mk0000001/Open-Pull-Profile/docs/superpowers/specs/2026-10-25-utm-mt02-engineering-iso.md

# UTM V2 / MT02 / engineering-filament feasibility

User scope: compare both projects in detail, source from Ali/China official direct and domestic Korea, assess an all-in KRW500,000 hardware budget, and design missing ISO-related features. User subsequently added PPS-CF, PA6-CF and engineering filaments broadly; confirmed room-temperature tensile testing first. Existing printer/PC/FreeCAD are owned equipment, not new purchases. No purchasing or supplier messages are authorised.

Latest superseding budget instruction: exclude printing costs, aim at KRW600,000 and remain strictly below KRW800,000. Printing filament, printer electricity and printing labour are excluded; purchased hardware, metal fabrication, freight and tax reserves remain included. PETG specimen comparison and engineering-material comparison are parallel routes. The earlier KRW500,000 analyses are retained as dated evidence, not the current budget. A small custom specimen does not satisfy the original full-size/ISO or minimum2kN requirement by itself. No hardware allocation converts an untested layout into a guaranteed load rating.

Preserve original source directories and frozen v0.1–v0.3 artifacts. Work in the existing isolated checkout on `codex/utm-mt02-iso-v0.4`. The original UTM V2 STEP is imported and saved as a separate local reference; its detailed mechanical shapes are not relabelled as a new original design. No authentic MT02 CAD repository has been located. A source-derived MT02 arrangement must say reconstruction, identify changed assumptions and not pretend to be a manufacturing replica.

Approaches examined: original UTM V2 (~1kN demonstrated) is the cheapest single-profile reference; original MT02 has metal mounts and dual ball screws but its 3.5kN is a target, with published comparison tests around800N. Neither existing result establishes the expanded engineering-material scope. Add a separate nominal10kN engineering layout and ISO-related coupon/grip/optical fixture study. This is an extension study authorised by the user's request to design missing features, not an unapproved purchase or certified machine.

Planning envelope: 10kN working target at23°C, nominal40mm² gauge section up to250MPa. Structural screening at15kN is a design input only, not a performed proof test. This bounded envelope does not assert every filament, continuous-fibre composite or conditioned state is covered. A1/A2 specimen names and ISO527-2:2025/ISO20753:2023 apply to the standards audit. Exact current radius/tolerance tables are not fully publicly verified; any generated dogbone is explicitly a nominal geometry study, not an ISO master.

Force, speed, alignment, slip, specimen dimensions, gauge strain, conditioning and AM build/orientation records must each be assessed. Crosshead steps are not a verified extensometer. Class1 force/extensometer performance requires calibration evidence over the used range; HX711 bit count and load-cell capacity are insufficient. Budget separates confirmed public unit prices, taxes/freight assumptions, fabrication allowances, contingency and unpriced calibration. Ali checkout/authenticated sellers remain unverified after a browser safety block; no bypass is attempted.
