mk0000001/Open-Pull-Profile/docs/superpowers/specs/2026-10-24-costdown-v03.md

# v0.3 cost reduction revision

The user changed sourcing to permit AliExpress, requested cheaper profiles and more printed parts, and asked for a quote before committing to a 2 kN machine. Keep the original AEP/HX711 option visible; compare an identifiable alternative rather than silently substituting a cheap scale sensor. Save the FreeCAD file during work. Preserve all upstream and v0.1/v0.2 artifacts.

Use original two geared NEMA17 / TR10x2 drives, original grip geometry and original functional planes. Replace the timber frame with two 4080 columns and three inexpensive metal crossmembers. Print feet, wraps, covers, beam pads and non-load-critical carriers. Metal crossmembers cost only KRW28,710 total at the verified length options; wholesale substitution of these with unqualified plastic is not a sensible 2 kN cost reduction.

The deliverable is a priced layout study, not a fabrication or load-rated release. Explicitly expose unresolved bearing reactions, shaft ends, sensor/grip threads, wiring and physical proof tests. Keep quoted prices, reference prices and allowances separate. The former industrial 2.16 million KRW subtotal was not CNC Kitchen's BOM price. Ali marketplace naming alone does not authenticate a manufacturer or establish a load rating.
