mk0000001/Open-Pull-Profile/UPSTREAM.md

# Provenance

- Original author: Stefan Hermann / CNC Kitchen.
- Original repository: https://github.com/CNCKitchen/Open-Pull
- Actual fork: https://github.com/mk0000001/Open-Pull-Profile
- Baseline commit: 55017419fae89409b1098540212e1620b1e46d0b (2020-06-04).
- License: original GPL-3.0 LICENSE retained. Added design sources use the same license.
- Original CAD/, Arduino/, Electronics/, Documents/ and LICENSE are preserved.
- Reused geometry: upper and lower ClampingYaw assemblies copied from original CAD/TestMachine/OpenPull-assembly.step, transformed into the profile frame coordinate system. They remain unvalidated original grip geometry, not new rated metal grips.
- Added work: profile-frame layout, adapters/envelopes, generator, checks, sourcing notes, Korean documentation.
- No other third-party tester code or CAD is incorporated. Alternative mechanisms are engineering proposals, not claims of endorsement by CNC Kitchen.
