mk0000001/Open-Pull-Profile/profile/DEVELOPMENT_LOG.md

# Development record — 2026-10-24

- User: printed tensile coupons for material/print-condition comparison; profile redesign based on CNC Kitchen; Ali/domestic sourcing with Coupang preference; publish an actual GitHub fork; maintain versions carefully.
- Baseline: original master 55017419fae89409b1098540212e1620b1e46d0b.
- Task1: design scope and provenance documented. Independent builder check found no planning blockers for the authorized concept stage.
- Task2 RED: native CAD validation failed with `Native FCStd has not been generated` before model generation.
- Task2 RED: first generated model failed the100mm pull collision check: crosshead bottom/rear intersected lower beams.
- Ruling: lengthen columns and screws from800 to900 and raise test/upper drive by100 — preserve100mm pull clearance — costs100mm additional overall height and slightly higher material cost.
- Task2 GREEN:58 part shapes valid; no moving-vs-frame/lower-bearing solid intersections at0/-100mm. Belt pitch length920mm at motor Y=-137.048851; proposed calibration640step/mm.
- Ruling: native CAD/source/envelopes are a design-review version, not machining drawings — vendor dimensions and hardware ratings unavailable — production fabrication still needs v0.2 interface work.
- Ruling: use AL6061-T6 as plate sourcing candidate and steel for grip adapters — manageable one-off weight and local availability — stiffness/strength and exact grade remain to be checked.
- Task3: sourcing differentiates product pages, search links, stale/indexed prices and unconfirmed options. No products ordered or supplier messages sent.
- Publishing: initial browser login was required. After user login, actual fork mk0000001/Open-Pull-Profile was created in the browser and profile branch created through the GitHub connector.
- Mechanical validation deferred: structural analysis, full hardware/mating tolerances, grip qualification, fall protection, electrical circuit, calibration and physical repeatability.
- Final review Important finding: omitted lower joint plate caused38400/57600mm3 intersections at-100mm. Expanded fixed-object and moving-block checks reproduced RED. Fix: lower joint plate height80 instead of160; upper plate remains160. Ruling: shorter lower joint plate clears pull path — lower attachment stiffness/rating still needs v0.2 verification.
- Render fix: assign camera-node rotations directly so front/right PNGs are orthographic views rather than frames during FreeCAD view animation.
- Final fix verification: expanded test covers12 moving components against15 fixed frame/support/rail objects at0/-100mm, with58 valid part shapes and no tested collisions. Important reviewer finding resolved RED→GREEN. No deferred minor findings.
- Publishing decision: preserve local development history and publish versioned trees through GitHub Git-data tools, then fetch the authoritative published history locally. Do not force-push or replace upstream history. Create a release tag and Git bundle backup after synchronization.
- User requested a full purchase/assembly audit after login. Manufacturer comparison found the actual3Nm example has10mm shaft/113mm body versus CAD8mm/112mm; actual HGH15CA mounting height28mm versus32mm envelope. ASSEMBLY_AUDIT.ko.md therefore records procurement/assembly HOLD; physical capacity remains unvalidated.
- Direct domestic option checks:4080 801-900mm selected28710KRW;401-500mm band adds15870 to base80 so15950KRW calculated. CAS SBA-500L selected198000KRW. No cart/checkout/supplier messages executed.
- Ruling: do not silently turn verified manufacturer examples into selected Ali/domestic purchases — exact vendor links and mating drawings are still missing — the present release remains a concept with a concrete no-build verdict.
- Published four milestones at GitHub; master/profile branch head3b42c55279079bae95baae74779d05abfe0cae67. Git trees were compared byte-for-byte against local design commits. Original local history retained as codex/local-history-20261024.
- GitHub Actions run40086259943 succeeded on the published head. Native CAD was independently closed/reopened and STEP imported into another document:58 native parts,76 STEP leaf shapes valid, relative volume difference1.6321e-14; bounds510x415x1067mm.
- Final report keeps assembly_ready=false. CI success is not treated as hardware assembly or strength approval.
