mk0000001/Open-Pull-Profile/profile/study-v0.4/QUOTE.ko.md

# 출력비 제외 견적 — 권장60만원 / 최대80만원 미만

2026-10-25 계획가. **권장589,084원 / 강화789,084원**. 배송·세금 충당금 및 예비비 포함, 출력 필라멘트·프린터 전기·출력 노동 제외. 공개 판매가와 미발주 가공/부품 충당금을 합친 예산안이며 결제 가능한 확정 견적은 아니다. [재계산 가능한 전체 항목](CURRENT_QUOTE.json), [독립 예산 검토](research/budget600-review.md).

| 구성 | 권장안 | 강화안 |
|---|---:|---:|
| 공개가 부품 소계 | 240,084원 | 240,084원 |
| 출력비 제외 기본 충당금 | 229,000원 | 229,000원 |
| 전원차단·limit·배선 추가 | 20,000원 | 20,000원 |
| 축 고정·지지·가공 추가 | 30,000원 | 80,000원 |
| 금속 국부 보강 / 그립·센서·반력부 추가 | 20,000원 | 120,000원 |
| 최종 운임·누락·초과 예비비 | 50,000원 | 100,000원 |
| **합계** | **589,084원** | **789,084원** |
| 각각60/80만원까지 여유 | 10,916원 | 10,916원 |

기본 충당금229,000원에는 2060×550 프로파일20,000 / 6001+칼라2개13,000 / 8→12 커플링15,000 / 전체 볼트·T너트35,000 / 그립표면5,000 / ATTiny6,000 / PCB20,000 / HX711 5,000 / 전장15,000 / 기본 차단·퓨즈·limit15,000 / 차폐20,000 / 국내배송25,000 / 국제배송25,000 / 세금·결제 불확실분10,000원이 포함된다. 추가 지원비와 중복하지 않도록 이 금액을 기본분으로 고정했다. 금속 가공은 위 배정액에 포함할 계획이며 실제 업체 견적은 받지 않았다. 일반 유상 조립 노동·공인 교정·고정밀 신율계는 미견적 별도다. **엄격한80만원 상한을 확정한 구매목록은 아직 아니다.**

## 공개 판매가

| 부품 | 수량 | 행 합계 | 근거 |
|---|---:|---:|---|
| STEPPERONLINE17HS19-1684S-PG100 | 1 | 45,276원 | [판매 페이지](https://www.stepperonline.co.kr/nema-17-%EC%8A%A4%ED%85%8C%ED%8D%BC-%EB%AA%A8%ED%84%B0-%EB%B0%94%EC%9D%B4%ED%8F%B4%EB%9D%BC-l-48mm-w-%EA%B8%B0%EC%96%B4%EB%B9%84-100-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) |
| Nasspop714 P0000BBM000H,300mm+MGN12H | 1 | 23,500원 | [판매 페이지](https://nasspop.com/product/detail.html?product_no=714&item_code=P0000BBM000H) |
| Nasspop678 MGN12H block only | 1 | 11,000원 | [판매 페이지](https://nasspop.com/product/detail.html?product_no=678) |
| Nasspop838 P0000BGG000I,T12 lead8x1000mm | 1 | 18,000원 | [판매 페이지](https://nasspop.com/product/detail.html?product_no=838&item_code=P0000BGG000I) |
| Nasspop838 P0000BGG000F lead8nut2400 +P0000BGG000V cut1000 | 1 | 3,400원 | [판매 페이지](https://nasspop.com/product/detail.html?product_no=838) |
| NACHI7201,NavimroK11504922,12x32x10mm,30deg | 2 | 28,578원 | [판매 페이지](https://www.navimro.com/p/K11504922/) |
| VCTEC13582,S500kg,P0000UCJ | 1 | 69,740원 | [판매 페이지](https://vctec.co.kr/product/detail.html?product_no=13582) |
| SZH-EK025 NanoCH340+USB | 1 | 6,050원 | [판매 페이지](https://www.devicemart.co.kr/goods/brand?category_code=00050001&code=1224) |
| VLT-OL023 SSD1306,128x64I2C | 1 | 6,490원 | [판매 페이지](https://www.devicemart.co.kr/goods/view?no=15960990) |
| SMG A4988RED,1327610,heatsink included | 1 | 1,980원 | [판매 페이지](https://www.devicemart.co.kr/goods/view?no=1327610) |
| ComsP5301,24V3A,1329320,ACcordincluded | 1 | 26,070원 | [판매 페이지](https://www.devicemart.co.kr/goods/view?no=1329320) |

국내 판매처와 제조사 중국 직구 조합이다. STEPPERONLINE 한국어 사이트는 국내 재고 판매라는 뜻이 아니다. 알리는 사이트 안전 차단 이후 우회하지 않았으며 판매자 정품·선택 옵션·한국 배송 결제가는 미확인이다. 쿠팡의 저가 기본 표시만으로 다른 슬롯/길이 프로파일을 대체 확정하지 않았다. 프로파일20,000원은 정확한 EU2060 단면·550mm 절단가를 확정하기 전의 충당금이다.

## 실제 시험 범위

**권장안:** PG100 연속 출력3Nm + T12 lead8은 스크루 효율0.3–0.5 가정에서707–1,178N 계산 후보이며 원형도 공개 실증 약1kN 수준이다. PETG 시험 시편5×2=10mm²에서40–60MPa는400–600N이다. PETG 전체10×4=40mm²는1,600–2,400N이므로 같은 기계로 전부 시험된다고 말할 수 없다.

**강화안:** 처음 구매할 때 같은 판매 페이지의 T12 lead2/해당 너트를 선택하는 개발안이다. 기존 조사에서 스크루18,000+너트2,400으로 lead8과 가격 차액0; 절단1,000. 이미 lead8를 샀다면 추가21,400원과 배송이 발생하므로 기존 견적에 그대로 끼워 넣을 수 없다.2kN에 필요한 토크는 같은 효율 가정에서1.27–2.12Nm이나 실제 저리드 효율은 미검증이다. 같은 출력rpm에서 속도1/4,steps/mm4배이며 펌웨어 변경과 부하 속도 실측이 필요하다. **2kN는 유지하는 개발 목표이며 보장 하중이 아니다.** 축력은 모터 허용 축하중50N으로 전달하지 않고 정격 축단·지지·반력판으로 닫혀야 한다.

**엔지니어링 병행:** 같은 장비에 별도4mm² 맞춤 비교 시편을 검토했다. 제조사 대표 XY 인장강도 기준 PPS-CF87MPa→348N,PA6-CF102MPa→408N,PPA-CF168MPa→672N이다.250MPa 소재면1,000N로 여유가 없다. 실제 단면·출력방향·함수율·열처리별 예비시험이 필요하며 단면을 줄이면 적층 경로와 파단 양상도 바뀐다. 이 시편은 ISO527 정규/축소 규격으로 검증된 형상이 아니다. 소재별 수치는 [제조사 근거·조건](research/engineering-filament-envelope.md)을 따른다.

## MT02와 전체 크기 엔지니어링 안

MT02 원형 상당 공개가 부분 합계577,160원, 저가모터·화면 대안514,773원은 금속10부품·가공·그립·체결·배선·차폐·배송 등을 빠뜨린 소계다. 출력비를 없애도 구매목록 전체가80만원 미만으로 입증되지는 않는다. [논문/BOM 검토](research/mt02.md).

원형 상당 안에 금속판/가공150,000,프로파일 천공·탭50,000,커플링30,000,체결55,000,PCB/전장40,000,그립/어댑터80,000,정지25,000,차폐25,000,국내배송30,000,국제배송/세금70,000을 임시 배정하면 **1,232,160원**,예비비100,000 포함 **1,332,160원**이다. 저가모터/화면 대안은 같은 충당금 가정에서1,169,773원/예비비 포함1,269,773원이다. 이는 업체 견적이 아니라 누락 금액을 드러내기 위한 계획가다. 소규모 금속가공을 모두 출력물로 바꾸고도2kN가 성립하는 설계는 아직 확인하지 못했다.

전체40mm²의 PPS-CF/PA6-CF/PPA-CF 대표 XY 파단하중은3.48/4.08/6.72kN다. 별도10kN 프레임/금속그립 설계를 저장했고 자동화 계획 범위는 **약164–303만원**이다. 핵심 지지부·가공 미견적이므로 확정가가 아니다. 수동잭 범위약104–206만원도 일정 시험속도/ISO 적합성을 자동 확보하지 않는다. [상위 하중 견적](research/10kn-upgrade-budget.md).600/800k 현 예산과 합치지 않고 향후 확장 비교 자료로 보관한다.

## 발주 전 해결해야 할 항목

1. 대체 모터·500kg 센서 실도면, 축/나사/높이/여기전압과HX711의 호환성. 원본 CAD 외형과 견적 부품이 동일하다는 주장을 하지 않는다.
2. lead2 너트 플랜지/축단·7201 방향·예압·좌면·칼라 유지력·커플링 토크, 금속 반력부의 실제 도면/가공가.
3. 출력부 인발·크리프·그립 미끄럼·편심·반복하중,정지/limit/과부하/ADC 오류 처리.
4. 교정된 기준으로 힘·부하속도·변위 검증. 인장탄성률을 보고하려면 게이지 길이의 교정된 접촉/광학 신율 측정도 필요하다.

일반 PETG는 **시험 시편 재료**다. 원형 기계 구조 출력물에는 제작자가 강성이 높은PLA계와6–8벽을 권하고 일반PETG를 비권장한다. 재료 이름을 공유한다고 구조부까지 PETG로 치환하지 않는다.
