mk0000001/Open-Pull-Profile/profile/study-v0.4/THIRD_PARTY.md

# Attribution and licensing boundaries

The repository's original CNC Kitchen source remains GPL-3.0 and unmodified.

`utm-derived/UTM_V2_budget_fixture_study.FCStd`, its STEP member in
`STEP_exchange.zip`, and `renders/UTM_V2_budget_fixture_study.png` derive from
Xieshi Zhang / CrazyBlackStone's Universal Tensile Testing Machine Version TWO,
assembly v50. The author describes the hardware as CC BY-NC-SA4.0:
https://hackaday.io/project/192166-low-cost-universal-tensile-testing-machine/
and https://github.com/CrazyBlackStone/Universal-Tensile-Testing-Machine .
License text: https://creativecommons.org/licenses/by-nc-sa/4.0/ .
These derived artifacts are distributed on those hardware attribution,
noncommercial and share-alike terms, not relicensed as CNC Kitchen GPL CAD.
The source repository also contains a GPL3 software license; no claim is made
that the licenses are interchangeable. Clarify the hardware grant before any
commercial distribution.

Changes: FreeCAD import/flattening of142 source leaf solids, jaw packaging for
2mm custom coupons, new PETG and engineering comparison coupons, metadata.
Quoted substitute motor/sensor are not the original solids. This is an
unvalidated packaging study. Source STEP Git blob SHA:
`c535fdf556560d4ac7aa4abba1db6c0b55a113a3`; filename:
`CAD Files/Tensile Testing Machine Assembly v50.step` (15584409 bytes).

MT02 is Stella Demmel's2024 TU Wien thesis:
https://repositum.tuwien.at/handle/20.500.12708/200949 .
The thesis is in copyright; its PDF and figures are not redistributed.
`MT02_source_derived_layout` is our reconstruction from published functional
dimensions, not the author's original FreeCAD model and not an exact replica.
Unresolved source drawing conflicts are recorded in the research and inputs.
Independent10kN requirements CAD and generated custom coupons are project
study artifacts under the repository license. None is a normative ISO master.
