mk0000001/Open-Pull-Profile/profile/domestic-v0.2/SENSOR_GRIPS.md

# 국내 로드셀·로드엔드·그립 조사

확인일: 2026-10-24. 2 kN은 설계 연구 목표이며 완성 장비의 검증된 허용하중이 아니다. 국내 사업자의 국내 판매를 기준으로 조사했고 해외 직구·구매대행은 채택하지 않았다. 가격은 발주 전 재확인해야 한다. 구매·판매자 연락·CAD 변경은 하지 않았다.

## 우선 선정

- **기준 로드셀: 국내용 CAS SBA-500L, 500 kgf(4.903 kN).** 카스몰 상품번호 `1000000249`, 용량 옵션 `SBA-500L`의 추가금 0원 확인, 표시가 198,000원. 카스 양주 주소와 국내 택배/방문수령 안내가 있다. [카스몰 실판매](https://cas-mall.com/goods/goods_view.php?goodsNo=1000000249). 디바이스마트도 동일 모델을 180,000원+VAT=198,000원, 평균 준비 3~4일로 표시한다. [디바이스마트 22818](https://www.devicemart.co.kr/goods/view?no=22818).
- **도면이 완전한 로드엔드 기준: THK NOS12T 우나사 무급유형.** 국내 원일에프에이·주노시스템 상품 `1000003150`에서 NOS12T/NOS12TL 선택 판매. 원문 HTML의 현재 기본가격은 14,520원이며, 검색 캐시의 13,200원보다 높다. 우나사 NOS12T를 지정한다. 국내 택배·인천 반품지·평균 1~3일 안내가 있다. [국내 판매](https://www.wjbearingmall.com/goods/goods_view.php?goodsNo=1000003150).
- **저가 후보: 한국미스미 E-GZW12.** M12×1.75 수나사·우나사·핀홀 12 mm·무급유를 국내 페이지에서 확인. 원문 상품 데이터의 기준 단가는 VAT 별도 3,360원, 포함 3,696원이며 주문정지 플래그는 0이다. 검색 결과에는 10/22 종료 프로모션이 함께 남아 있어 현재 결제 가격/재고를 확정하지 않는다. 전체 d12 치수표와 CAD는 한국판 원문으로 추가 대조 후 채택한다. [한국미스미 E-GZW12](https://kr.misumi-ec.com/vona2/detail/110310557009/?HissuCode=E-GZW12).

## CAS SBA-500L의 실제 도면과 모델링 기준

일반적인 S자 상자 치수가 아니라 **카스 공식 국내 PDF 1쪽의 제품도면, 2쪽의 액세서리도면**을 시각 대조했다. 국내 공식 제품 소개도 200 kgf~1 tf에 M12×1.75 액세서리를 명시한다. [공식 SBA 제품](https://www.cas.co.kr/integration/read.jsp?code=20200813f2610ff062&no=115&reqPageNo=1), [공식 2쪽 PDF](https://www.cas.co.kr/upload/goods/1600822642799_398.pdf).

| 국내 200~500 kgf 행 | 확인 치수(mm) | 의미 |
|---|---:|---|
| A | 51 | 정면 폭 |
| B | 76 | 인장축 방향 본체 높이 |
| C | 19 | 본체 두께 |
| D | 27 | 양 측면 덮개 포함 두께 |
| E | 12.6 | 상하 끝 블록 두께, **나사 유효깊이와 다름** |
| 2-F | M12×1.75 | 상하 인장 포트 |
| 케이블 | 3 m | 인출부 포함 외형 길이는 별도 미치수화 |

CAD 좌표는 인장축을 Z, 정면 51 mm 폭을 X, 두께 19/27 mm를 Y로 두면 된다. 두 포트는 상하면에서 Z 방향으로 체결한다. 도면 중심선은 동축으로 그려져 있으나, 포트의 X/Y 오프셋 공차·유효 탭 깊이·S 슬롯 곡률·케이블 글랜드 돌출 길이는 공개 도면에서 수치화되지 않았다. 이 부분을 정확한 제조 형상으로 단정하지 않는다.

CAS 전용 로드엔드 조립체(200 kgf~1 tf)의 치수는 다음과 같다.

| 공식 액세서리 기호 | 값(mm) |
|---|---:|
| A, 전체 길이 | 211.1 |
| B, 양 핀 중심 간 거리 | 177.1 |
| C, 헤드 외경 | 34 |
| D, 구면 내륜 폭 | 16 |
| E, 홀더 폭 | 12 |
| F, 핀홀 | Ø12 |
| G, 내륜 끝 외경 | Ø15.4 |

`177.1 = 76 + 2×50.55`, `211.1 = 177.1+34`는 조립 치수의 산술 해석이다. 액세서리 독립 주문 형번·정격·스터드 세부 치수·삽입 깊이는 미공개다. **이 길이를 THK/미스미 대체 로드엔드에 그대로 적용하면 안 된다.**

## THK 대체 로드엔드 및 금속 연결부

THK 공식 한국어 카탈로그 A23-10~13에서 아래 수치를 확인했다. [THK 공식 도면/정격 PDF](https://tech.thk.com/upload/product_data/upfile/512K_23_RodEnd.pdf).

| 항목 | NOS12T / POS12 |
|---|---|
| 나사 | M12×1.75 수나사, 우나사; 접미 L은 좌나사 |
| 전체 길이 L / 핀 중심→스템 끝 L1 | 69 / 54 mm |
| 헤드 외경 D | 30 mm |
| 나사부 길이 ℓ | 33 mm |
| 핀홀 d | Ø12 H7 |
| 내륜 폭 B1 / 홀더 폭 B | 16(0/-0.1) / 12 mm |
| 내륜 끝 외경 d1 / 볼 직경 | 15.4 / 22.225 mm |
| 정 레이디얼 하중 용량 Cs | NOS12T 11,000 N / POS12 16,700 N |
| 재질 | 홀더 S35C, 내륜 SUJ2 58HRC 이상 |

Cs는 시험기 조립체의 안전사용하중이나 피로수명이 아니다. 인장축은 로드엔드 스템 축이며 핀에는 레이디얼 하중을 전달한다. THK는 보통하중 핀 끼워맞춤 h7을 안내한다. 대체 급유형 POS12도 국내배송 명시 판매가 있다. [에스엘시스템 POS12](https://myslmall.com/product/pos12-%EC%82%BC%EC%9D%B5thk-%EC%9D%BC%EC%A0%9C-%EC%88%98%EB%82%98%EC%82%AC-%EB%B6%80%EC%B0%A9-%ED%83%80%EC%9E%85-%EB%A1%9C%EB%93%9C%EC%9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).

SBA와 THK를 직접 체결할 때 핀 중심 간 거리는 `H = 76 + 2×(54-e) = 184-2e mm`이며 e는 실제 나사 삽입 깊이다. CAS의 H=177.1로 맞추면 e=3.45 mm에 불과하므로 이를 조립 목표로 삼지 않는다. 센서 탭 깊이·물림 길이·잠금너트·자유 회전 여유를 정한 뒤 H를 결정해야 한다.

**금속 클레비스 설계 입력:** 핀 Ø12, 내륜 폭 16 mm와 그 공차를 수용하는 안쪽 간격, 헤드 Ø30 및 각운동 여유, 양 귀에서 핀을 지지하는 구조. 원본 STEP을 검사한 상위 작업자의 확인값은 그립 축방향 구멍 **Ø17 mm, 깊이22 mm**이며 나사는 모델링되어 있지 않다. 이를 M8이나 M16 나사라고 단정할 수 없다. 센서의 M12 포트와 연결하는 금속 인서트/어댑터는 이 실측 형상에 맞춘 별도 가공품으로 정의한다. Ø12 핀만 보고 안쪽 폭 12 mm인 일반 공압 포크를 고르면 내륜 폭 16 mm와 맞지 않는다. 정확히 맞는 국내 기성 클레비스 형번은 이번 조사에서 확정하지 못했다.

한국미스미의 `CLBDG12-35` 플랜지·너트 고정 힌지핀은 구매 가능한 **검토 후보**다. Ø12 g6, 축부 길이 35 mm, M10×1.5 끝나사, 플랜지 Ø18·두께5, S45C 계열이다. 실제 귀 두께·간격·스페이서에 따라 길이를 다시 고르고, THK의 h7 권장과 g6의 간극 차이를 검토한다. 핀/클레비스 조립의 하중 정격은 미검증이다. [한국미스미 형번](https://kr.misumi-ec.com/vona2/detail/110300095930/?HissuCode=CLBDG12-35), [제조사 치수표](https://jp.misumi-ec.com/vona2/detail/110300095930/).

## 그립: 국내 판매와 성능 확인의 차이

| 후보 | 국내 판매 근거 | 채택 판단 |
|---|---|---|
| CNC Kitchen 원본 ClampingYaw | 보존된 `CAD/TestMachine/OpenPull-assembly.step`; 원본 README는 AEP TC4 5 kN 센서 사용을 언급 | 원형 유지/금속 어댑터 연구는 가능. 센서 용량이 출력 그립의 2 kN 검증을 뜻하지 않음 |
| 쿠팡 와이엠툴 집게형 지그 | 100,000원/1개, 업체직송 표기, 상품 6904740090 | 모델·정격·나사·치수도 공개 확인 불가. 2 kN 확정 BOM 제외. [실제 쿠팡 판매](https://www.coupang.com/vp/products/6904740090) |
| IMADA PGC-2530 | 다인계기 상품1000013915, 916,700원 VAT 포함, 국내 택배/안산 수령지·평균2~5일 안내 | 정격2500N, M10, 턱폭30 mm, 입벌림15 mm, 약750 g. **상부용 검토만 가능:** 제조사는 자중 영향 때문에 스탠드 하부 그립으로 사용하지 말라고 명시. 두 개를 상하 한 쌍으로 선정하면 안 됨. [국내 판매](https://www.dain21.net/goods/goods_view.php?goodsNo=1000013915), [공식 사양·도면·주의 p2/4](https://www.forcegauge.net/pdf/pgc_e.pdf) |

PGC-2530의 제조사 구성 예시는 상부 PGC-2530 + 하부 GTW-2500N이다. 하부품의 국내 특정 판매 옵션은 확정하지 못했다. 저예산 경로는 원본 기구를 보존한 금속 턱/몸체·Ø17×22 구멍에 맞는 전환부의 가공 설계와 실물 검증이며, 원본 출력물의 허용하중을 2 kN으로 기재하지 않는다. [IMADA 공식 구성 예](https://www.forcegauge.net/en/product/detail/pgc010).

## HX711 연결과 측정 한계

SBA는 증폭기 없는 4선 브리지, 정격 출력 3.0±0.3 mV/V다. 권장 여자 10 V, 최대15 V, 입력400±25 Ω, 출력350±3.5 Ω이며 표준/선택 C3 사양을 구분해야 한다. 허용 과부하150%는 장비 운전 정격이 아니다. [CAS 공식 PDF](https://www.cas.co.kr/upload/goods/1600822642799_398.pdf).

HX711은 브리지 입력용 ADC로 gain128에서 차동 입력한계가 `±0.5×AVDD/128`이고 전원은2.6~5.5 V, 출력속도는10 또는80 samples/s다. 예를 들어 브리지와 AVDD를 동일4.3 V로 구동하면 SBA 명목 정격 신호는12.9 mV, 2 kN에서는 약5.26 mV로 범위 안이다. **10 V로 여자한 브리지를 5 V HX711에 그대로 직결하면 공통모드/정격 입력 범위에 맞지 않는다.** 저전압 여자 시 CAS의 정확도 보증 조건은 별도 확인하고 최종 구성 그대로 교정해야 한다. [AVIA 제조사 HX711 데이터시트 사본](https://datasheet.lcsc.com/lcsc/Avia-Semicon-Xiamen-HX711_C43656.pdf).

연결 기능은 E+/E−→여자, A+/A−→차동 신호이며 실제 납품 케이블 색상표를 기준으로 배선한다. 공식 국내 PDF에 색상별 결선이 없어 임의 색상을 지정하지 않았다. ADC의24비트는 장비 정확도가 아니다. 표준 SBA 결합오차0.03%RO를 500 kgf에 환산하면 약1.47 N, 선택 C3의0.02%라면 약0.98 N이며 이는 ADC·조립·온도·교정 오차를 더하기 전이다. 10 SPS는100 ms, 80 SPS는12.5 ms 간격이므로 빠른 파단 피크가 누락될 수 있다. 최종 회로에서 영점 잡음, 구간별 기준하중, 증하중/감하중 반복, 드리프트와 포화, 파단 피크 기록을 검증해야 한다.

## 보류 항목

- 더 싼 CAS SBA 표시가140,800원 페이지는 ‘현재 구매할 수 없는 상품’ 표시가 있어 대체 구매처로 채택하지 않았다. [카스맥시스템 SBA](https://www.scaledpt.kr/product/detail.html?product_no=698&cate_no=72&display_group=1).
- 쿠팡의 무브랜드 S형500 kg 센서는 국내 재고·원제조사 도면·추적 가능한 형번을 함께 확인하지 못해 제외했다. 싱글포인트/시어빔500 kg 제품은 S형 인장 로드셀의 바로 대체품이 아니다.
- 설계 확정 전 남은 값: SBA 유효 탭 깊이와 연결 규정, 대체 로드엔드 물림/잠금너트 높이, 미스미 E-GZW12 한국판 전체 치수·정격, 금속 클레비스 가공도/핀 조립간극, 그립 미끄럼·파손 하중, 전체 정렬·과부하 차단 검증.
