mk0000001/Open-Pull-Profile/docs/superpowers/plans/2026-10-25-utm-mt02-engineering-iso.md

# UTM / MT02 engineering study implementation plan

> **For agentic workers:** REQUIRED SUB-SKILL: Use superpowers:executing-plans to implement this plan task-by-task. Steps use checkbox (`- [ ]`) syntax for tracking.

**Goal:** Deliver source-backed two-project reviews, bounded engineering-material force requirements, updated600k/strict800k feasibility excluding printing costs, and saved FreeCAD designs for missing metrology/fixture features.

**Architecture:** Independent research reports feed a versioned study package. Keep the original UTM reference separate; reconstruct MT02 from published functional dimensions with explicit gaps. Model a separate10kN extension concept and nominal coupons/grip/optical fixtures without upgrading geometric validity into ISO compliance.

**Tech Stack:** FreeCAD1.1/Python, original STEP, public standards previews, manufacturer technical data, JSON price/evidence records.

**Spec:** docs/superpowers/specs/2026-10-25-utm-mt02-engineering-iso.md

## Global Constraints

- Room temperature23°C first; PPS-CF/PA6-CF/PPA-CF and other conventional engineering FFF grades are included in a stated force envelope.
- Latest budget: recommended KRW600,000, strict ceiling below KRW800,000, excluding printing costs. Retain the historical KRW500,000 comparison as dated evidence. Do not drop purchased hardware, freight, fabrication or calibration caveats to fit a headline.
- Working target10kN, screening input15kN, neither physically tested.
- Preserve all original and frozen design files; no purchase, external message or Ali policy bypass.

## Review Focus

- Source capacity headline versus actual demonstrated test load and rated component limits.
- Incomplete totals, hidden import/VAT/fabrication/filament costs and unquoted items.
- Flexural versus tensile data, print orientation, moisture and annealing state.
- Nominal coupon geometry versus latest standard geometry and verification requirements.
- Camera/step resolution versus measured force/strain accuracy and low-force dynamic range.

## Tasks

- [x] Inspect clean isolated branch; preserve prior artifacts; import and save original UTM STEP reference.
- [x] Research UTM V2, MT02 and ISO requirements independently; expand material research after user adds engineering filaments.
- [x] Consolidate source URLs, BOM quantities/prices and all mandatory missing costs into reproducible JSON totals.
- [x] Generate source-derived MT02 layout and independent10kN extension/coupon/fixture concepts; save native after frame and after completion.
- [x] Save parallel UTM-derived PETG/custom engineering coupon packaging study with explicit third-party licensing and unverified substitute-component interfaces.
- [x] Verify reopened CAD, selected mounting/clearance/force-envelope invariants and exported STEP pairing. Record all unresolved mates.
- [x] Independently review evidence/claims, fix important findings, commit and publish the study without a certification or build-ready claim. Published draft PR1; first remote push CI40111816113 passed. Native/STEP and price evidence are preserved; physical procurement/assembly/2kN/ISO work remains outside the achieved feasibility-study checks.
