mk0000001/Open-Pull-Profile/docs/superpowers/plans/2026-10-24-costdown-v03.md

# v0.3 execution plan

1. Freeze the abandoned industrial/500 N studies outside the release; retain previous revisions unchanged.
2. Reuse upstream component solids at documented world transforms. Build profile replacements and bed-sized printed wraps/feet/pads, save native CAD after both stages.
3. Export STEP and individual new printed candidates; visually inspect native assembly and reopen native/STEP for geometric validity and volume checks.
4. Build a machine-wide quote with verified prices versus explicit allowances, original and alternate sensors separately, and a clear 500,000 KRW gap.
5. Run manifest/upstream preservation checks; request independent review of artifacts and claims. Commit and publish a costdown-layout revision with no fabrication-ready or 2 kN guarantee claim.
