mk0000001/Open-Pull-Profile/profile/study-v0.4/research/iso.md

# 출력 시편 인장시험의 ISO 요구사항

확인일 2026-10-25. 대상은 필라멘트로 출력한 인장 시편의 재료·출력조건 비교다. 공개 ISO 카탈로그, 표준 판매처의 합법적 미리보기, 시험기 제조사 문서를 조사했다. 유료 표준 구매·우회·문의, CAD·Git 변경은 하지 않았다.

출력 시편으로 강도를 비교할 수 있다. 다만 모양·로드셀 정격·ADC 비트수만으로 ISO 적합성을 주장할 수 없다. 50만 원 예산에서는 먼저 재현성 있는 비교시험을 구현하고 계측 검증의 범위를 명시하는 접근이 현실적이라는 판단이다.

## 현재 판

| 문서 | 공식 카탈로그 확인 | 용도 |
|---|---|---|
| ISO 527-1:2019 | 2025 확인, 현재 판; 개정 진행 표시 | 일반 원칙 [S1] |
| ISO 527-2:2025 | 2025-06-18 발행, 2012판 대체 | 경질·반경질 성형/압출 플라스틱 [S2] |
| ISO 20753:2023 | 발행 상태, 후속 CD 개발 중 | 시편 치수·명칭 [S3] |
| ISO 7500-1:2018 | 2026 확인 | 힘 측정계 교정·검증 [S9] |
| ISO 9513:2012 | 2022 확인, Cor.1:2013 별도 존재 | 신율계 교정 [S11] |
| ISO 291:2008 | 마지막 확인 2021, 2026 검토 상태 | 상태조절·시험 분위기 [S12] |
| ISO 16012:2015 | 2026 확인 | 시편 치수 측정 [S13] |
| ISO 17295:2023 | ISO/ASTM 52921:2013 대체 | AM 위치·좌표·방향 표현 [S14] |
| ISO/ASTM 52924:2023 | 발행 상태 | MEX/PBF 열가소성 AM 부품 특성 등급화 [S15] |
| ISO/ASTM 52927:2024 | ISO 17296-3:2014 대체 | AM 부품 주요 특성과 시험방법 [S16] |

527-2:2025는 1A/1B를 **A1/A2로**, 기존 Annex A의 1BA/1BB를 **ISO 20753 축소 시편으로** 바꿨다. A1은 직접 사출한 다목적 시편, A2는 기계가공 시편이다. 축소 시편에는 Annex A와 ISO 20753을 함께 적용한다. 따라서 새 형상을 연도 없이 “ISO 527-2 1BA”라 표시하지 않는다. [S2,S5,S6]

AM 시편 자체를 배제할 이유는 없다. ISO/ASTM 52924는 MEX/PBF 열가소성 출력 부품을 명시적으로 다룬다. 다만 출력 A1 모양이 사출 A1과 같은 재료상태를 보장하지는 않는다. 이번 시험은 명시한 출력조건의 인장특성 비교로 설명한다. 낮은 infill 구조의 결과를 벌크 재료 고유 물성으로 해석하지 않는다. 527-2는 1 mm 미만 유연 필름, 일반 강성 발포체/셀 구조와 적용범위가 다르며 연질 TPU에는 별도 검토가 필요하다. [S2,S15; 적용 판단 포함]

## 공개 원문으로 확인한 사항

필수·선호·권고를 구분한 제한적 요약이며 전체 표준을 대체하지 않는다.

| 항목 | 내용 | 조항·구분 |
|---|---|---|
| 힘 측정계 | ISO 7500-1 class 1 | 527-1 §5.1.4 필수 [S4] |
| 신율계 | 접촉식 ISO 9513 class 1, 비접촉식 동등 정확도 | §5.1.5.1 필수 [S4] |
| E용 신율 정확도 | L0=50 mm: ±1 µm; 75 mm: ±1.5 µm; 20–50 mm: ±1 µm | §5.1.5.1 필수 [S4] |
| 그립 | 축 일치, 미끄럼·조기파단·압궤 방지 | §5.1.3 필수 [S4] |
| 반복 | 요구 방향마다 최소 5개, 그립 내부 파단/미끄럼 교체 | §7 필수 [S4] |
| 상태조절 | 재료규격 우선; 부재 시 ISO 291, 최소 16 h(합의 예외) | §8 [S4] |
| 분위기 | 선호 23±2°C·50±10%RH; 수분 비민감성 예외; 시험도 같은 분위기 | §8·9.1 [S4] |
| 치수 측정 | 폭 0.1 mm, 두께 0.01 mm 단위 | §9.2 [S4] |
| E 구간 | 변형률 0.05–0.25% | §3.9 정의 [S4] |
| 인장강도 | 첫 국부 최대 응력 | §3.6.2 정의 [S4] |
| 양면 변형률 평균 | 굽힘 오차 억제 | §5.1.5.1 권고 [S4] |

527-2:2025 §5.2는 **A1의 표점거리 75 mm를 선호**하고 QC/별도 지정 시 50 mm를 허용한다. 이를 A2의 75 mm 권장으로 확대하지 않는다. 현재 Zwick 설명은 A2에 50 mm를 제시한다. §5.3의 22 Hz는 v=1 mm/min, L0=75 mm, 초기 그립간격 L=115 mm, 신호 분해능 r=0.0005 mm인 예다. 모든 시험의 고정 샘플링 하한은 아니다. [S5,S6,S7]

class 1은 정격의 ±1%라는 뜻이 아니다. 제조사 자료는 지시값 오차뿐 아니라 반복·영점·분해능·가역성 등을 해당 측정범위에서 다룬다. 24 bit ADC나 원래 로드셀 정격이 조립계 전체의 등급을 입증하지는 않는다. [S9,S10; 해석 포함]

## 속도: 50 mm/min을 보편적 기본값으로 주장하지 않기

현재 Zwick 공식 설명은 **A1/A2 탄성률 1 mm/min**, 이후 5 또는 50 mm/min을 재료거동에 맞춰 사용한다고 설명한다. 527-1 §5.1.2의 선택 속도 공차 유지가 필요하며 1 mm/min 공차는 ±20%다. 50 mm/min을 모든 플라스틱 강도의 필수/기본 속도라고 확인한 근거는 없다. [S4,S7]

합법적 공개 ISO 527-2:2012 미리보기 §8은 탄성률에 1 mm/min을 요구하고 나머지는 527-1의 절차를 참조한다. 이는 **구판 근거**다. 최신 527-2:2025 §9 전체는 무료 미리보기에 없어서 원문으로 대조하지 못했다. [S18]

2019 §9.6의 “재료규격 우선, 없으면 Table 1 또는 당사자 합의” 문구는 공개 검색에서 대학/재게시 전문에 나타났으나 재배포 권한을 확인하지 못해 이번 보고서의 합법적 1차 검증 근거로 채택하지 않았다. 따라서 **1 또는 5 mm/min의 문서화된 연구 비교 프로토콜**은 제안할 수 있어도, 특정 재료 표준 또는 ISO 10350-1의 단일점 비교데이터 조건까지 충족한다고 약속하지 않는다. ISO 10350-1도 2025판으로 개정되어 별도 대조가 필요하다. [S19]

T12 리드 2 mm·감속 99.5:1 가정의 계산: 1/5/50 mm/min에서 나사 0.5/2.5/25 rpm, 모터 약 49.8/248.8/2487.5 rpm이다. 저속 2 kN 달성이 가능하더라도 50 mm/min·2 kN 동시 성능은 별도 문제다. 고속 정격을 암시하지 않고 실제 하중별 속도·스텝손실을 검증한다. 이 계산은 ISO 조항이 아닌 설계 해석이다.

## 시편 치수의 확인 수준

**현재 최종판 치수표·공차를 완전히 검증하지 못했다.** ISO 20753:2023 공개 PDF는 본문 p4까지여서 §6.2 Table 3/4가 없다. 527-2:2025 Table 1과 Annex A 전체도 공개 무료 미리보기에서 확보하지 못했다. 구판 공차를 2023/2025 공차로 승격하지 않는다. [S5,S17]

| 예비 기구 입력 | A1 계열 | A2 계열 | 확인 수준 |
|---|---:|---:|---|
| 좁은부 폭 | 10 mm | 10 mm | 구 제조사 브로슈어 명목 [S8] |
| 두께 | 4 mm 선호 | 4 mm 선호 | 동일 |
| 좁은 평행부 길이 | 80 mm | 60 mm | 동일 |
| 탭 폭 | 20 mm | 20 mm | 동일 |
| 전장 | ≥170 mm | ≥150 mm | 동일 |
| 초기 그립간격 | 115 mm 명목 | 115 mm 명목 | 현재 공차 보류 |
| 표점거리 | 75 mm 선호 / 50 mm 조건부 | 50 mm | 현재 §5.2·제조사 [S5,S7] |
| 반지름·l2·모든 현재 공차 | 보류 | 보류 | 현행 최종 표 대조 필요 |

20×4 mm 탭을 중심 정렬하는 그립 카트리지, 115 mm 부근 초기 간격 조정, 75/50 mm 카메라 표점 치구는 예비 설계에 쓸 수 있다. 표점거리와 그립간격은 다르다. 전장 전체가 기계 스트로크는 아니고, 그립 높이·최종 연신량을 더해 실제 작업공간을 산정한다. **현재 ISO 시편의 제작용 표준원도는 미출도**다.

20753:2023 §6.1 공개 부분은 풀사이즈가 불편하거나 재료가 적을 때 Axy 축소형을 설명한다. x는 제작방법, y는 1:y 축척이다. Zwick 현재 안내는 A22/A25와 CW를 설명하지만 CW의 주용도는 노화·노출 전후 상대 비교다. CW 또는 임의의 5×2 mm 목 단면을 일반 강도 비교용 현행 ISO 승인 형상이라고 부르지 않는다. Annex A의 사용조건·속도와 최종 치수표가 필요하다. [S7,S17]

작은 시편을 같은 형상·같은 제작조건으로 비교하는 연구는 가능하다는 공학적 판단이다. 대형/소형 또는 다른 제작법 결과를 그대로 합치지 않고 “ISO 527 참고, 사용자 정의/축소 시편, 편차 명시”로 기록한다.

## 하중 범위와 기계 차이

F(N)=예상 최대응력(MPa)×단면(mm²). 단순 하중계산이며 구조 안전율·계측 여유·동적 오버슈트는 포함하지 않았다. 기계 선정은 ISO의 첫 국부 최대 정의뿐 아니라 전체 시험 중 최대 힘도 고려한다.

| 단면 가정 | 면적 | 50 MPa | 60 MPa | 80 MPa | 100 MPa |
|---|---:|---:|---:|---:|---:|
| 10×4 mm | 40 mm² | 2.0 kN | 2.4 kN | 3.2 kN | 4.0 kN |
| 10×2 mm | 20 mm² | 1.0 kN | 1.2 kN | 1.6 kN | 2.0 kN |
| 5×2 mm | 10 mm² | 0.5 kN | 0.6 kN | 0.8 kN | 1.0 kN |

뒤 두 단면은 하중 예시이며 현행 ISO 적합 치수를 승인한 것이 아니다.

| 쟁점 | CrazyBlackStone UTM V2 | TU Wien MT02 | 필요한 증거 |
|---|---|---|---|
| 용량 가정 | 약 1 kN 보고값 | 3.5 kN 목표값 | 이 보고서에서는 독립 인증하지 않음 |
| 40 mm²에서 용량/면적 | 25 MPa | 87.5 MPa | 구조·계측 여유 별도 |
| 기존 2 kN 요구 | 가정상 미달 | 목표상 가능 | 전체 하중경로 검증 |
| 80 MPa×40 mm² | 부족 | 3.2 kN으로 목표 대비 0.3 kN 차이뿐 | 실제 정격·여유 검토 |
| 공간·그립 정렬 | 미확인 | 미확인 | 20 mm 탭·115 mm 간격·유효 스트로크 |
| 힘 class 1 범위 | 미확인 | 미확인 | 장착된 계측계 전체 교정·검증 |
| E용 신율 정확도 | 미확인 | 미확인 | 표점 신율계/교정된 광학계 |
| 실제 속도·DAQ | 미확인 | 미확인 | 하중별 속도·동기 기록 |

2 kN은 10×4 mm 단면의 50 MPa에 해당하므로 모든 일반 필라멘트 출력물을 풀사이즈로 파단시킨다는 범위가 아니다. 80 MPa까지 필요하면 3.2 kN에 여유를 더한 설계 요구를 별도 지정한다. 가격·재고·조달은 코디네이터의 견적 조사 범위다.

## 50만 원 비교시험기의 최소 업그레이드·운영 권고

다음은 공학적 권고이며 표준 전문이나 견적을 대신하지 않는다.

1. 프레임·나사·너트·베어링·연결구·로드셀·그립의 전체 하중경로를 검토한다. 모터 정지토크만으로 기계 정격을 정하지 않는다.
2. 센터링 지그와 재현 가능한 그립 죔을 설계하고, 미끄럼·그립파단을 영상과 파단 위치로 확인한다. 편심과 굽힘은 특히 E를 왜곡한다.
3. 실제 사용할 힘 범위 여러 점을 추적 가능한 기준으로 검증한다. 반복·영점복귀·히스테리시스·드리프트·노이즈를 확인한다. 저하중 추 교정만으로 2 kN class 1을 표시하지 않는다.
4. 스텝 명령과 실제 크로스헤드 변위·속도를 독립 측정한다. 프레임/그립/탭 변형을 포함한 크로스헤드 이동은 표점 신율이 아니다.
5. E 또는 표점 연신율을 보고하려면 신율계를 추가한다. 카메라는 길이척도·렌즈왜곡·카메라 움직임·조명·표식 추적 정확도를 검증한다. 픽셀수/서브픽셀 알고리즘만으로 ±1 µm를 보장하지 않는다. 검증하지 못한 E는 미보고한다.
6. 힘·신율·변위의 공통 타임스탬프와 원자료를 저장한다. 센서부터 기록까지 실제 전달률·필터 지연을 검증한다. 위 22 Hz 예 설정에서 10 sample/s는 충분하다고 주장하지 않는다. 80 sample/s도 정확도 증거가 필요하다.
7. CAD치수 대신 출력 후 단면을 실측한다. 필라멘트 건조 이력과 출력 후 상태조절을 구분한다. 측정 단위는 기기 전체 측정불확도와 같은 개념이 아니다.
8. 시험축·적층 Z축·래스터 방향을 좌표그림/각도로 기록한다. XY/XZ 두 글자만으로 시험축이 모호하면 그림을 추가한다. ISO 17295를 표현 기준으로 참조한다. [S14]
9. 재료 lot·수분·프린터·노즐·층높이·온도·속도·벽·상하층·infill·래스터·냉각·슬라이서/버전·G-code·배치 위치·후처리를 고정/기록한다. 100% infill 설정을 무공극으로 가정하지 않는다.
10. 그룹별 개별곡선·유효 수·평균·표준편차·파단 위치·제외 사유·계측범위/교정정보를 보고한다. 외형 단면 응력을 infill 비율로 다시 나누어 재료 고유강도로 바꾸지 않는다.

권장 표시: **“ISO 527-1:2019 및 ISO 527-2:2025를 참고한 출력 시편 비교 인장시험. 제작·형상·계측·상태조절 편차는 기록하며 정식 적합성은 미검증.”**

## 원선과의 짧은 구분

1.75 mm 원선 시험은 원선의 축방향 성질을 보며 층간 접합·공극·래스터를 평가하지 못한다. 원형 균일 단면 가정 A≈2.405 mm²에서는 50/80 MPa가 약 120/192 N이다. 실제 직경·타원도와 고정법 검증이 필요하고 ISO 527-2 A1/A2 시험이라 부르지 않는다.

## 출처·접근 한계

- S1 [ISO 527-1](https://www.iso.org/standard/527-1): 현재 판·확인연도.
- S2 [ISO 527-2](https://www.iso.org/standard/527-2): 발행·대체·명칭·범위.
- S3 [ISO 20753](https://www.iso.org/standard/83642.html): 현재 판·개발 상태.
- S4 [EN ISO 527-1 공개 미리보기](https://standards.iteh.ai/catalog/standards/cen/63eedfdd-676e-48bd-9a33-3d274e612cd7/en-iso-527-1-2019): 사이트 `Standards Content (Sample)`의 규정 텍스트, §3–9.3. 자동 생성 소개와 원문을 구분. 무료 PDF보다 사이트 공개 텍스트가 더 길었음. §9.6·Annex C 전문 미확보.
- S5 [ISO 527-2:2025 공개 미리보기](https://standards.iteh.ai/catalog/standards/iso/9d55cbc8-5096-4e1e-bb26-ce74eea5c4d9/iso-527-2-2025): 목차·변경내역·§1–5.2 일부. 무료 PDF 3쪽, Table 1/Annex A 전체 미접근.
- S6 [EVS 2025 미리보기](https://www.evs.ee/et/StandardDownload/DownloadPreview?language=EnglishLanguage&productId=161842): 검색 색인 본문 p2의 §5.2·5.3·6.1 확인. 직접 열면 로그인형 다운로드 화면이어서 전체 PDF 확보하지 않음. [제품 범위](https://www.evs.ee/en/iso-527-2-2025)와 대조.
- S7 [ZwickRoell 현재 ISO 527 안내](https://www.zwickroell.com/industries/plastics/thermoplastics-and-thermosetting-molding-materials/tensile-test-iso-527-1-2/): A1/A2·축소/CW 용도·속도·계측. 제조사 해설. 일반적인 최대강도 설명보다 ISO 원문의 첫 국부 최대 정의를 우선.
- S8 [ZwickRoell 브로슈어](https://www.zwickroell.com/fileadmin/content/Files/SharePoint/user_upload/Brochures_EN/Industry_Brochures/99_269_Testing_of_Plastics_and_Rubber_E_EN.pdf): §5.1 예비 명목 치수. 구 공차를 현행 공차로 사용하지 않음.
- S9 [ISO 7500-1](https://www.iso.org/standard/72572.html): 현재 판과 검증 범위. 전문 교정절차 미접근.
- S10 [Xforce K 제조사 자료](https://www.zwickroell.com/fileadmin/content/Files/SharePoint/user_upload/PI_EN/03_677_Xforce_K_load_cells_PI_EN.pdf): 다섯 성능기준 설명. DIY 계측계 인증자료가 아님.
- S11 [ISO 9513](https://www.iso.org/standard/41619.html): 현재 판·정오표. 전문 미접근.
- S12 [ISO 291](https://www.iso.org/standard/50572.html): 현재 판·검토 상태.
- S13 [ISO 16012](https://committee.iso.org/standard/63481.html?browse=ics): 현재 판·범위. 팁/압력 등 전문 미접근.
- S14 [ISO 17295](https://www.iso.org/standard/76471.html?browse=tc): AM 좌표·방향·위치.
- S15 [ISO/ASTM 52924](https://www.iso.org/standard/76909.html): MEX/PBF 열가소성 AM 등급화. 등급화의 시편 수·배치·통계 전문은 이번에 검증하지 않음. 527의 최소 5개를 52924 등급화 충족으로 확대하지 않음.
- S16 [ISO/ASTM 52927](https://www.iso.org/standard/81802.html?browse=tc): AM 시험 특성과 절차. 전문 미접근.
- S17 [20753:2023 공개 PDF](https://cdn.standards.iteh.ai/samples/83642/3f31c860b40e4957b873a9fabbf2153d/ISO-20753-2023.pdf): 본문 p1–4, Axy 정의·Table 1 일부. 최종 치수 Table 3/4 미포함.
- S18 [527-2:2012 공개 PDF](https://cdn.standards.iteh.ai/samples/56046/c5c3ec20cc0741289bf6def861e0a40b/ISO-527-2-2012.pdf): 구판 §8의 E 속도. 2025판 대체물로 사용하지 않음.
- S19 [ISO 10350-1:2025](https://www.iso.org/standard/85826.html): 단일점 비교데이터의 별도 현행 규격. 최신 속도표 전체는 미검증.

비공식 재게시 전문의 재배포 권한은 확인하지 못해 근거로 채택하지 않았다. 두 기계의 자체 정격과 국내/AliExpress 견적은 별도 검증 대상이다.
