mk0000001/Open-Pull-Profile/profile/study-v0.4/research/mt02.md

# MT-02 primary-source audit and Korea budget evidence

Checked 2026-10-25 KST. Research only. No vendor contact, purchase, CAD change, or Git change performed. Files here are ignored research intermediates.

## Conclusions the public report can safely state

1. MT-02 is a materially different design from MT-01: twin geared NEMA17 motors, twin SFU1605 screws, 4080 metal frame, aluminum load-bearing mounts, Arduino Mega, touchscreen. The official thesis is Stella Demmel (TU Wien,2024), DOI10.34726/hss.2024.113842.
2. The thesis specifies a3.5kN goal and computes3.388kN available axial force. The comparison experiment is five PETG specimens per machine with MT02 mean peak800.346N. It does not demonstrate a calibrated2kN or3.5kN operating range. Preserve2kN as our design/validation target, not proven inherited rating.
3. AppendixA.1 has an exact parts list and fastener list, but no prices or total. The official MT01 README underEUR500/1.5kN claim must not be applied to MT02.
4. The selected currently listed near-original Korea procurement basket already sums to about577,160KRW before metal fabrication, several mandatory parts, and delivery/tax unknowns. A dual-direct-NEMA23/3.2touch alternative gives about514,773KRW before the same missing lines. Neither is a complete sub500,000KRW quote. A cheaper Ali-heavy design may be possible but has not been established by verifiable selected-option checkout prices.
5. Native MT02 FreeCAD/PCB/firmware repository and an applicable design license were not located. The thesis says FreeCAD was used; this does not establish downloadable native sources. A CAD recreation should be called MT02-inspired reconstruction from published dimensions, never authentic MT02 CAD.

## Primary sources and reproducibility

- Official record: https://repositum.tuwien.at/handle/20.500.12708/200949
- Official PDF (the literal ellipsis is part of the actual repository filename): https://repositum.tuwien.at/bitstream/20.500.12708/200949/1/Demmel%20Stella%20-%202024%20-%20Design%20manufacturing%20and%20testing%20of%20an%20open-source...pdf
- LocalPDF: mt02-thesis.pdf,3,634,180bytes. Download succeeded with PowerShell Invoke-WebRequest using normal OS certificate trust. No certificate bypass.
- PDF77pages, printed body numbered1–66. Printed page number = PDF page minus11 for these sections.
- Geometry/BOM structured data: mt02-bom.json. Raw relevant geometry text: mt02-geometry-extract.json.
- Rendered figure pages: mt02-pdf-page-29.png (assembly/frame, printed18); -31.png (profiles drawing, printed20); -33.png (mounts drawing, printed22).
- Full extracted text: mt02-thesis.txt and mt02-thesis-layout.txt. The PDF embeds some drawing text as vector paths, so the rendered figures were visually inspected; extraction alone omits dimensions.

MT01 source audit, kept separate:

- https://gitlab.tuwien.ac.at/ilsb-public/mt01
- Public API README https://gitlab.tuwien.ac.at/api/v4/projects/3827/repository/files/README.md/raw?ref=main
- Native assembly https://gitlab.tuwien.ac.at/ilsb-public/mt01/-/blob/main/01_Design_Parts/00_Assembly_FreeCad/Assembly.FCStd
- Current README explicitly licenses MT01©2021–2026DieterH.Pahr underCCBY-NC-SA4.0; it states underEUR500 and up to1.5kN.
- Public API searchmt02 returned[]; ILSB Public group listed onlymt01 andparosol. This is evidence of search outcome, not proof no MT02 source exists anywhere.
- Thesis official record says InCopyright. No native MT02 hardware/software license identified; do not copy MT01 license onto a reconstruction by inference.

## What the thesis actually validates

Printedpp27–28/PDF38–39: thrust calculation3.388kN; the practical travel speed is capped450mm/min for noise, not because of a measured load-speed envelope.

Printedpp35,39–40/PDF46,50–51: manual test0.5–6mm/min, force/time/travel output at5Hz; no separate position sensor, displacement comes from commanded step count. One motor can be jogged independently to realign the crosshead. Movement is hold-to-run on the touchscreen. Force limit is used in manual test mode; travel and other modes ignore load-cell readings. The described overload indications include stepper knocking and possible bottom-beam sliding at bracket joints. These are not a demonstrated calibrated mechanical overload limiter.

Printedp42/PDF53: calibration used a0.5kg reference mass, tare before each specimen,30–40Npreload and1mm/min test speed. The reused MT01 grips haveM8threads while MT02 was designed forM12; improvised washers/M10spacers andM12-toM8adapter were used. Grip/adaptor procurement is missing from the Appendix table.

Printedpp48–56/PDF59–67:fivePETGtests per system; strength agrees approximately1percent, but corrected crosshead-derived modulus0.717GPa versus Zwick video1.483GPa is under by48percent. Corrected ultimate strain7.581percent versus3.869percent is roughly96percent higher. Original raw crosshead-based modulus0.342GPa is even lower. This cannot be sold as accurate modulus/strain measurement without specimen-level optical tracking or a validated compliance correction. A two-sample t-testp=.690 withn5 is not a general equivalence certificate. The thesis has small internal discrepancies for Zwick mean strength40.642/40.648/40.842MPa; report approximately40.4versus40.8MPa instead of overclaiming the final decimal.

AppendixA.2 printedpp64–65/PDF75–76:INA219 current sensing was tried to detect missed steps and discarded because it could not detect them. A4988 was rejected for heat/low speed;DM320T was rejected for abnormal speed behavior. Do not add INA219 to the final validated sensor list or imply a closed-loop force/position system.

Engineering implication (our inference): a low-mass calibration extrapolated to800Ncomparison does not verify2kN/3.5kN. Before claiming2kN, bench verification must cover mounting/joint stiffness, gripper slip, twin-drive synchronization, force zero/span/repeatability/hysteresis through the intended range, and independent measured crosshead travel. A camera can retain a low-cost specimen-strain path, but a purchased camera or calibration target must be budgeted unless already owned.

## Exact BOM and geometry

See mt02-bom.json for all quantities and13fastener rows. Main facts:

- 4080groove8I-type light profiles:590mm×2columns,400mm×3(top+2feet),320mm×1fixed lower beam,300mm×1crosshead; total3000mm.
- Twin500mmSFU1605spindles on244mm centers; original17HS19-1684S-PG19motor×2with19.203:1gearboxes;8-to10mmcoupler×2;DM542T×2.
-5kN wording inbody,500kg wording inBOM forS-type loadcell, M12interface.500kgf=4.903kN, and sensor range does not rate the entire machine.
- Frame nominal400wide×400deep×670high inferred from components, excluding motors/caps. Label this inferred envelope.
- Ten machinedAW6060mounts:2each motor70×78×6,fixed-bearing70×78(6mm inferred),nut80×55×10,floating80×69×10,loadcell/grip60×80×10.
- Low-stress printed parts are housings/caps/cable caps/spacers, not the primary force path. PETG1mmspacers under motor/fixed-bearing mounts;TPUendcap dampers.

Published inconsistencies requiring purchaser drawing verification before fabrication:

- BOM flatbar10×70×500 conflicts with80mmwide finished mounts and prose10×80.
- Fig17nut-mount holes are labeledM4; prose says sixM5holes. DrawingPCD38.23mm.
- Feet drawing appears to labelØ12.25counterbore; prose specifiesØ13.5,12.25deep. Resolve against intendedM8head and selected profile.
- Fixed supportBK12named in printedp26. Floating supportBF12 is plausible from standard component geometry but is not explicitly part-numbered in the BOM. Do not replace withFK12/FF12 silently.

## Current sourcing comparison, not a checkout quote

Listed prices checked2026-10-25. VAT added only when the seller explicitly saysVATexcluded. Foreign manufacturer KRW pages do not mean Korean domestic stock. Final destination shipping/importVAT/cardcurrency fees are unverified.

| Item | A near-original listing amount KRW | B costdown amount KRW | Evidence / limitation |
|---|---:|---:|---|
|4080profile3m|91,500|91,500|Ajin3050/100mm tariff calculation; exact cuts/rounding/kerf, I-type groove match and freight not verified. https://e-ajin.com/product/detail.html?product_no=39 |
|SFU1605L500supportsets×2|158,000|158,000|Mizo exact500mm variant79000 each. Seller option literallyBK12EF12, so support geometry unresolved. https://mizo.kr/product/detail.html?product_no=96&item_code=P00000DS00EE |
|Motors×2|88,888.8|56,240.8|A original geared17HS19-1684S-PG19; B direct23HS30-2804S2Nm. Manufacturer KRcatalogues; overseasdispatch.|
|DM542T×2|60,522|60,522|Exact official product JSON-LD30261each. https://www.stepperonline.co.kr/nema-17-23-24-%EC%8A%A4%ED%85%8C%ED%8D%BC-%EB%AA%A8%ED%84%B0%EC%9A%A9-%EB%94%94%EC%A7%80%ED%84%B8-%EC%8A%A4%ED%85%8C%ED%8D%BC-%EB%93%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 |
|S500kgloadcell|68,200|68,200|VCTEC62000exVAT. Verify tension/compression rating, thread/pitch, geometry. https://vctec.co.kr/product/detail.html?product_no=21203 |
|Mega2560compatible|23,000|23,000|Eduino domestic listing. https://eduino.kr/product/detail.html?product_no=41 |
|HX711|1,870|1,870|DeviceMart1700exVAT. https://www.devicemart.co.kr/goods/view?no=1327440 |
|24V8.8APSU|35,640|35,640|MEANWELLLRS-200-24equivalent, not thesis exact unidentifiedPSU. https://www.devicemart.co.kr/goods/view?no=13231951 |
|3.2touchLCD|49,539.6|19,800|A SSD1289module45036exVAT, shield still missing. B ILI9341THL-CD01SPI18000exVAT. Needs firmware/pin/3.3Vlogic changes.|
|Partial total|577,160.4|514,772.8|No full total is known.|

Motor sources:

- Original official KRcatalogue https://www.stepperonline.co.kr/nema-17-%EC%8A%A4%ED%85%8C%ED%8D%BC-%EB%AA%A8%ED%84%B0%EC%99%80-%EA%B2%BD%EC%A0%9C%EC%A0%81%EC%9D%B8-%ED%94%8C%EB%9E%98%EB%84%88%ED%8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 shows44444.40KRW. Original USprimary page shows28.86USD https://www.omc-stepperonline.com/nema-17-stepper-motor-bipolar-l-48mm-w-gear-ratio-19-1-planetary-gearbox-17hs19-1684s-pg19
- Costdown official KRcatalogue https://www.stepperonline.co.kr/arduino-%EC%8A%A4%ED%85%8C%ED%8D%BC-%EB%AA%A8%ED%84%B0 shows23HS30-2804S28120.40KRW,57×57×76.5mm,6.35mmshaft. Holding torque is not running torque or a calibrated machine rating.
- A LCD https://vctec.co.kr/product/detail.html?product_no=4834 ; B direct listing https://www.devicemart.co.kr/goods/view?no=15454164 (THL-CD01).

The tables do NOT include:10metal mounts andmachining, originalLCDshield/ribbon,PCBfabrication orrewireboard,2couplings,4brackets,34slotnuts,fasteners,PETG/TPU,grippers/compressionplatens/adapters,DCconverter,powerjack/switch/fuse/mainscord/earth,USBcable,limits/emergency-off ifadded,calibrationfixture,delivery/taxes/camera/labor/tools. Adding nominal allowances without verified sources would be an estimate, not a sourced sub500k quotation.

B retains twin drives, tension/compression, live force/touch interface, USBlog and independent realignment as an intended redesign. It requires newmotor mounts/couplings and firmware settings and touchscreen library changes; it is not a drop-in MT02 build.2kNremains a validation target. The thesis itself suggests a stronger direct motor to simplify mounting (printedp57/PDF68).

## A defensible route toward the500kconstraint

First prioritize an engineering budget ceiling rather than falsely claiming a purchase-ready BOM. At500kall-in, components must cost materially below500kto leave delivery, machining andfixture reserve. The verified dual-motor basket does not achieve that.

Potential future costdown: oneNEMA23+oneDM542Tdriving both screws with a2:1timing belt; lower-cost matchedscrew/supportkits; simplemetalplates using ownedtools; keepS-cell/HX711/USB/touch; use an existingcamera for strain. This changes thedrive topology and independent motorjog is replaced by mechanicalphasealignment. The belt/couplers/mounts needdesign andnewprocurement quotes, and motorholding torque cannot prove2kN. Do not present this unquoted concept as retaining every original function or as completeunder500k.

For original-equivalentassembly, credible budget is above the577kpartialbasket by the missinglines; no precisecomplete total is justified yet. For a500kstrict cap, currently justified status is procurement feasibility unconfirmed, not impossible and not established.

AliExpress constraint: ko.aliexpress.com was safety-blocked earlier. It was not accessed through anotherbrowser/rawnetwork here. No selected capacity/length/model shipping-to-Korea checkout prices verified. Searchsnippets/pricehistory/authorlinks must not be substituted for a live purchasable quote.

## Quality checks performed

- Reopened officialPDF:77pages, no embeddedattachments.
- Visually inspected3renderedassembly/dimensionpages and crosscheckedprose.
- Reopened/parsedmt02-bom.json and recomputedbothsubtotals.
- Differentiated hidden soldouttemplate from live status onVCTEC/Ajin usingpublicHTML:loadcell andLCD4834 haveis_soldout_icon=F, notconfirmedoutofstock. VCTEC4851 integratedscreen shield actuallyhasis_soldout_icon=T andis notcounted.
- No trackedfilesedited.
