mk0000001/Open-Pull-Profile/profile/study-v0.4/research/budget600-review.md

# 출력비 제외 60만원 권장 / 80만원 미만 강화안 독립 검토

2026-10-25. 최신 예산은 **출력용 필라멘트·프린터 전기·출력 노동 제외, 권장 600,000원 / 최대 800,000원 미만**이다. 기존 `utm-v2-bom.json`의 500,000원은 이전 조사 조건이며 이 문서가 예산 해석을 갱신한다. 기존 JSON·CAD·추적 파일은 수정하지 않았다. 구매·판매자 연락·Ali 재접근은 하지 않았다.

**판정: 60만원이면 약 1 kN급 원본 복제 후보의 조립·정지·축 고정을 보완할 여지가 생긴다. 80만원 미만에서는 lead 2와 금속 반력부를 포함한 2 kN 개발 후보로 진전시킬 수 있다. 어느 쪽도 조립 완료·정격 2 kN 검증을 의미하지 않는다.** 10 kN 전체 크기 엔지니어링 시편용은 이 저가 BOM의 예산 범위에서 성립했다고 볼 수 없으므로 별도 설계·견적 과제로 남긴다.

## 예산 배분표

기존 공개가를 다시 합산하면 240,084원, 충당금은 259,000원이다. 여기에서 출력재 30,000원만 제외해 **공통 기초 계획 469,084원**을 얻었다. 출력 전기·출력 노동은 원래 합계에 없었으므로 다시 차감하지 않았다. 아래 추가액은 **발주 확정가가 아닌 용도가 지정된 충당금**이다. 새 확정가를 주장하지 않으므로 신규 판매가를 임의로 넣지 않았다. 공통 금액에는 국내 운송 25,000원, 국제 운송 25,000원, 수입세금/결제비 불확실분 10,000원, 기본 차폐판 20,000원, 기본 전원차단/퓨즈/limit 15,000원이 이미 들어 있다.

| 항목 | 60만원 권장안 | 80만원 미만 강화안 | 확보하려는 실제 개선과 제한 |
|---|---:|---:|---|
| 기존 공개가 부품 | 240,084원 | 240,084원 | PG100×1, MGN12H 300 mm+블록2, T12/너트/절단, 7201×2, 500 kg S로드셀, Nano/OLED/A4988/24V3A. 구매 옵션·실물 치수 확인 전 |
| 출력재를 제외한 기존 충당금 | 229,000원 | 229,000원 | 위 배송/세금/차폐/전장, 2060, 6001/칼라, 커플링, 볼트류 등. 합배송/최종 VAT·재고 미확정 |
| 외부 전원차단·limit·배선 보강 추가 | 20,000원 | 20,000원 | 기존 15,000원에 더해 총35,000원 한도. 비상정지 접점으로 드라이버 전원을 실제 차단하는 부품·퓨즈·배선 선정. 인증 안전회로 완성 비용이라는 뜻은 아님 |
| 정격 커플링·축 칼라·베어링 지지 추가 | 30,000원 | 80,000원 | 기존 커플링15,000+6001/칼라13,000원 외 추가. 강화안은 축단/베어링 좌면 소가공 및 금속 고정 지지까지 우선 배분. 부품 허용토크·축 유지력과 실제 가공가 확정 필요 |
| 그립/고정 지그/반력부 금속 보강 추가 | 20,000원 | 120,000원 | 권장안은 금속 받침·와셔/국부 보강 수준. 강화안은 그립/로드셀 어댑터·베어링 반력판과 필요시 백본 보강을 우선. 전체 금속 그립 가공 확정 견적 아님 |
| lead 변경 | 0원 | 0원 차액 | 권장 lead8 유지. 강화는 처음 구매할 때 T12 lead2 스크루/너트 선택: 기존 조사에서 같은 18,000/2,400원. lead8를 산 뒤 추가 구매하면 별도21,400원 및 배송 발생 |
| 최종 운임·가공 초과·누락 부품 예비비 | 50,000원 | 100,000원 | 조립 전에 도면과 공급가를 확정하며 사용. 교정 성적서·기준 힘 측정기를 이 금액에 구매할 수 있다고 가정하지 않음 |
| **출력비 제외 계획 합계** | **589,084원** | **789,084원** | 모두 위 충당금과 예비비 포함 |
| **상한까지 여유** | **10,916원** | **10,916원** | 600,000원 / 800,000원 각각 기준. 강화안은 800,000원보다 작음 |

이 금액은 “해당 금액으로 정격부품·가공·교정이 전부 확보됐다”는 견적이 아니다. 정격 커플링/지지·금속 반력부의 실견적이 배정액과 예비비를 초과하면 보강을 생략하지 말고 범위·예산을 다시 정해야 한다. 공인 힘 교정, extensometer, 기준기 신규구매, 일반 조립/가공 노동은 확정 견적이 없다. 사용자가 제외한 것은 출력 노동이며 금속가공·조립 노동까지 무료로 승인한 것으로 간주하지 않았다. 위 금속 보강액은 재료/소가공 충당금이고 일반 유상 조립 인건비는 별도다.

## PETG 기본안과 엔지니어링 축소시편안

PETG **시험 시편**을 기본으로 삼는 것과 기계의 출력 구조부를 PETG로 만드는 것은 별개다. CrazyBlackStone 원문은 높은 강성의 PLA계 출력과 6–8개 벽을 권하고 일반 PETG 구조부를 쓰지 말라고 한다. 따라서 원본 지그/베어링 하우징을 그대로 PETG로 치환한 조립을 권장하지 않는다. PETG 구조부를 원하면 별도 형상 보강·크리프/층간 검증이 필요하다. 이번 원가에서 출력비를 빼더라도 이 재료 한계는 사라지지 않는다. [원문 조립·출력 지침](https://hackaday.io/project/192166/instructions)

실제 파단하중은 `인장강도 MPa × 실측 단면 mm²`다. **10×4 mm=40 mm² 시편은 2 kN에서50 MPa**에 해당한다. PETG라는 재료명만으로 파단하중이1 kN 또는2 kN 이하라고 단정하지 않는다. 시편 방향·인필·건조·실제 두께를 기록하고 예비 시험으로 범위를 확인한다.

엔지니어링 비교용 축소시편은 하중을 줄이는 별도 운용안이다. 현재 확인한 Bambu PPA-CF XY 대표168 MPa라면 5×2 mm=10 mm²에서 **1,680 N**, 4 mm² 맞춤 단면에서 **672 N**이다. 선택한 재료 상한250 MPa로 계산하면 각각 **2,500 N / 1,000 N**이다. 따라서 lead8 약1 kN급 후보에는 4 mm² 사례가 더 현실적이지만250 MPa에서조차 여유가 없고, 대표 강도에만 맞춘 시편 선택을 보증으로 취급하면 안 된다. 축소하면 적층 경로·벽/인필 비율·그립/게이지 형상의 영향이 달라지므로 **ISO527 전체 크기 적합 시험이나 기존 최소2 kN 충족으로 표시할 수 없다.** [공식 PPA-CF TDS V1.0](https://store.bblcdn.eu/s8/default/f592e57fe69c40289897513bdd2b61bc/Bambus_PPA-CF_Technical_Data_Sheet_2ab26420-79f5-4692-888e-090006814050.pdf)

## 아직 남는 조립 및 2 kN 문제

- **PG100+lead8:** 제조사 연속 출력3 N·m와 스크루 효율0.30–0.50라는 가정에서 계산상707–1,178 N다. 약1 kN 수준 후보라는 기존 판단을 유지한다.2 kN에는5.09–8.49 N·m가 필요해 연속3 N·m를 넘는다. 순간5 N·m를 연속 정격으로 쓰지 않는다. [제조사 PG100](https://www.stepperonline.co.kr/nema-17-%EC%8A%A4%ED%85%8C%ED%8D%BC-%EB%AA%A8%ED%84%B0-%EB%B0%94%EC%9D%B4%ED%8F%B4%EB%9D%BC-l-48mm-w-%EA%B8%B0%EC%96%B4%EB%B9%84-100-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)
- **lead2 강화 후보:** 같은 효율 가정에서2 kN 필요 토크는1.27–2.12 N·m로 줄어든다. 그러나 작은 lead에서 실제 효율이 동일하다는 보장은 없으므로 구동 실험이 필요하다. 같은 출력 회전수에서 속도가1/4이고, 스텝/mm 설정은4배다. 원본 lead8 설정을 그대로 두면 속도·변위가 틀린다. 기존 조사 SKU는 [Nasspop838](https://nasspop.com/product/detail.html?product_no=838)의 스크루 `P0000BGG000G`, 너트 `P0000BGG000D`, 절단 `P0000BGG000V`다. 실제 너트 플랜지 구멍/축단·베어링 좌면은 대조 전이다.
- **축력 반력:** 모터축 허용 축하중50 N에 시험 축력을 직접 전달하면 안 된다.7201 방향·예압, 6001의 실제 역할, 칼라/축단 어깨, 커플링 삽입 길이와 미끄럼 토크를 정해야 한다. 베어링 단품 정격만으로 출력 하우징의 인발·지압을 보증할 수 없다.
- **시편·센서 장착:** 실제500 kg 로드셀의 나사/중심높이/체결 길이·bridge excitation, 그립 개구·유효 stroke·시험 간격, 편심·그립 미끄럼을 확인해야 한다. 센서 정격약4.9 kN를 시험기 정격으로 옮기지 않는다. 금속 보강에도 하중이 출력부/T너트로 우회하지 않는 반력 경로가 필요하다.
- **검증:** 교정된 힘 기준으로2 kN까지 단계하중·반복·영점복귀·미끄럼·영구변형을 확인하고, 정지/과부하/limit/ADC 오류 동작을 시험해야 한다. 아직 물리적 하중 시험·ISO 적합성·2 kN 달성은 확인되지 않았다. 이번 예비비를 교정 완료 증거로 취급하지 않는다.

**진행 권고:**60만원안은 PETG 및 제한된 축소 엔지니어링 시편의 비교 시험용 시제품 조립에 초점을 둔다. 최소2 kN가 필수이면80만원안에서lead2·정격 축 고정·금속 반력부를 우선 검토하고, 실견적과 검증 결과가 나오기 전에는2 kN 완성품으로 부르지 않는다.23°C 전체 크기 엔지니어링 시편용10 kN 설계는 계속 별도 보관한다.
