mk0000001/Open-Pull-Profile/profile/study-v0.4/research/engineering-iso-addendum.md

# 엔지니어링 FFF 재료 범위 확대: ISO 보충 검토

확인일 2026-10-25. 사용자 범위는 PPS-CF·PA6-CF를 포함한 엔지니어링 FFF 재료, 시험온도는 실온 23°C다. 앞선 `iso.md`를 보완하며 CAD·Git·구매·문의는 변경/실행하지 않았다.

**권고 결론:** 넓은 엔지니어링 재료군을 40 mm² 단면으로 시험한다면 10 kN 작업 범위를 검토할 이유가 있다. 그러나 “모든 엔지니어링 필라멘트”는 무제한 범위이므로 **예상 최대응력 250 MPa 이하·단면 40 mm² 이하·23°C·지정한 출력/수분 상태**처럼 경계를 명시한다. 10 kN은 이 경계의 산술 결과이며 현재 DIY 기계의 검증된 정격이 아니다. 15 kN 구조 예비 목표도 검증되지 않았다.

## 1. CF라는 이름만으로 ISO 파트를 정하지 않는다

| 재료·구조 | 관련 현행 ISO | 적용 판단 |
|---|---|---|
| 짧게 절단한 CF가 충전된 경질/반경질 성형·압출 컴파운드 | ISO 527-2:2025 | 범위에 short fibres 충전·보강 컴파운드가 포함됨. 보통의 PPS-CF/PA6-CF 필라멘트 비교의 출발점이 될 수 있음 [E1] |
| 비일방향 섬유 보강의 등방/직교이방 복합재 | ISO 527-4:2023 | 매트·직물·로빙·chopped strands뿐 아니라 short/milled fibres도 포함. 사출 시편은 527-2를 참조한다는 주석 있음 [E2] |
| 완전히 또는 주로 한 방향으로 정렬된 섬유·로빙·테이프 등의 보강 | ISO 527-5:2021 | 일방향 복합재. 서로 다른 각도의 UD층을 쌓은 다방향 적층은 보통 527-4 [E3] |

따라서 “CF는 전부 527-4”, “단섬유는 언제나 527-2”, “래스터가 0°이면 자동으로 527-5”라는 분류는 피한다. 실제 섬유의 길이·연속성·정렬·적층 구성, 시편 제작법, 재료/AM 시험규격과 고객의 시험 목적을 함께 정한다. 단섬유 FFF 출력물에도 유동에 따른 섬유배향과 적층 이방성이 있을 수 있으며, 이는 연속 UD 보강과 같은 의미가 아니다. 이 문단은 공개 범위를 바탕으로 한 적용 판단이다.

출력 A1형 dog-bone의 사용을 결정하더라도 직접 사출 A1과 동일한 재료상태라는 주장은 하지 않는다. AM 문맥에는 ISO/ASTM 52924:2023·52927:2024 및 ISO 17295:2023의 방향/위치 표현을 함께 검토한다. 527-4/-5를 선택하면 dog-bone·탭·그립·시험속도 등을 527-2에서 그대로 옮길 수 있다고 가정하지 않는다. 해당 파트의 시편과 파손모드 요구를 다시 확인해야 한다. [E2,E3,E4]

## 2. PA6-CF 수분 상태: 23°C와 건조는 서로 다른 조건

ISO 1110:2019는 2024년에 확인된 현행 PA/공중합 PA 시편의 가속 상태조절 규격이다. 충전재/첨가제를 포함한 grade도 범위에 들어가지만 2 mass%를 넘는 추출성분 grade는 제외한다. 얻는 평형 수분은 23°C/50%RH와 가깝고 기계적 결과가 조금 다를 수 있다고 ISO가 명시한다. PPS-CF 등 모든 재료의 일반 가속 조절법은 아니다. [E5]

ISO 16396-2:2022는 PA 성형·압출 재료의 시편 제작/특성 규격이다. 공개 미리보기에서 다음을 확인했다. 이 규격의 모든 조항을 FFF에 자동으로 전용한다는 뜻은 아니다. [E6]

- §5.1: 시편의 수분 상태를 보고하며 건조 상태·moist 상태 또는 둘 다의 특성을 다룬다.
- §5.2의 **dry-as-moulded(DAM)**는 단순히 “시험 전 오븐 건조”가 아니다. 성형 직후 방습 보관, 23±2°C에서 최소 24 h, 수분 2 g/kg 이하, 꺼낸 뒤 최대 15 min 이내 시험 등의 정의가 있다. 기준을 넘은 시편을 다시 건조하거나 사전 열처리한 시편을 이 DAM 상태로 부를 수 없다.
- §5.3의 **moist**는 23°C/50%RH에서 평형 도달, 또는 ISO 1110 가속 조절이다. 분위기 등급/공차와 수분 함량을 보고한다. 일반 527의 최소 16 h만으로 PA 평형 도달을 보장하지 않는다.
- §4.1의 성형 전 수분 검증에는 ISO 15512가 인용된다. 이 조항의 대상·재료 범위와 별도로 판단해야 한다.

ISO 15512:2019도 2024년에 확인된 현행 규격이다. 분말·과립·완성품의 **물 함량 측정법**이며 ISO 62의 흡수속도/평형 시험과 다르다. 이것 자체가 모든 ISO 527 또는 모든 FFF 시험에 자동으로 추가되는 의무라는 근거는 확인되지 않았다. 선택한 재료규격/시험계약이 요구하거나 물 함량을 검증할 필요가 있을 때 방법을 정한다. 단순 질량 감소식 수분계가 해당 방법·분해능·시료량에 맞는지도 확인한다. [E7]

이번 비교시험에서는 예를 들어 `23°C, 출력 후 건조·밀봉 상태`와 `23°C, 지정 RH 평형 상태`를 별도 그룹으로 정의한다. 필라멘트의 출력 전 건조, 출력 직후 보관, 출력 후 annealing, 흡습 조절, 시험 전 실온 안정화의 이력을 각각 남긴다. **필라멘트를 건조해서 출력했다는 사실은 시험 시편의 수분 상태를 증명하지 않는다.** 제조사의 annealed/dry/wet 수치를 비교할 때도 각 상태와 시험속도·방향을 맞춘다. 이는 실무 권고다.

## 3. 축소 시편으로 하중을 낮추는 경우

최신 ISO 527-2:2025는 A1/A2와 ISO 20753 축소 시편을 참조한다. ISO 20753:2023 공개 §6.1은 풀사이즈가 불편하거나 재료량이 작을 때 Axy 축소형을 설명하며 x는 제작방법, y는 1:y 축척이다. 현재 Zwick 안내는 A22/A25를 제시한다. 공개된 2023 FDIS 표에는 A12/A22를 1:2로 설명하지만, **FDIS는 최종판 치수표 대신 쓰지 않는다.** [E8,E9]

최종 20753:2023의 §6.2 Table 3/4, 527-2:2025의 Table 1/Annex A 전체를 합법적 무료 미리보기에서 확보하지 못했다. 그러므로 이 보충 검토도 반지름·축소 공차·표점거리·속도를 확정하지 않는다. 임의로 목 폭/두께만 줄이거나 인필을 낮춘 형상을 **full ISO**라고 표시하지 않는다.

단면 10 mm²와 40 mm² 결과는 같은 응력단위로 계산할 수 있어도, 형상·제작·섬유 분포·벽 비중·노치/모서리·변형률속도·파손위치에 따른 차이가 있으므로 동등성을 자동 보장하지 않는다. 짧은 섬유와 비드 폭에 비해 작은 시편에서는 대표성도 별도로 검토한다. 작은 형상 연구가 필요하면 같은 형상과 프로토콜 안에서 비교하고 편차를 명시한다. 이는 공학적 적용 판단이다.

CW는 특히 노화/열·환경 노출 전후 특성의 상대 변화에 활용되는 작은 시편이다. 기계 힘 한계를 맞추기 위한 일반 고강도 ISO 표준 시편의 대체로 자동 승인하지 않는다. [E9]

## 4. 실온 고강도 재료의 힘 범위

F[N]=σ[MPa]×A[mm²]. 아래는 예상 **전체 최대 응력**을 쓰는 설계 계산이며, ISO 인장강도의 첫 국부 최대 정의와 구분한다. 강도값은 재료명만으로 확정할 수 없으므로 해당 제품의 인장 TDS·방향·상태를 대조한다. 굽힘강도를 인장강도로 대입하지 않는다.

| 예상 최대응력 | A=10 mm² | A=40 mm² |
|---:|---:|---:|
| 50 MPa | 0.50 kN | 2.0 kN |
| 100 MPa | 1.00 kN | 4.0 kN |
| 150 MPa | 1.50 kN | 6.0 kN |
| 200 MPa | 2.00 kN | 8.0 kN |
| 250 MPa | 2.50 kN | 10.0 kN |

**10 kN 작업 목표**는 250 MPa×40 mm²를 포함하는 유한한 설계 범위다. 15 kN 예비 구조 목표는 10 kN의 1.5배를 고려하는 설계 선택일 뿐, 파괴하중·허용하중·proof load 또는 안전율을 검증한 수치가 아니다. 프레임·그립·나사·너트·베어링·핀·로드셀·연결구 전체와 편심·피로·운동·과부하 차단을 확인하기 전 작동 정격으로 표시하지 않는다. 2 tf 센서는 약 19.6 kN 정격일 수 있지만, 이것이 프레임을 19.6 kN으로 인증하지 않는다.

PPS-CF 역시 제품마다 다르다. 예를 들어 Bambu 공식 페이지의 인장강도 87±5 MPa를 단순 예측에 사용하면 40 mm²에서 명목 3.48 kN이다. 이는 MT02의 보고된 **3.5 kN 목표**와 사실상 여유가 없으므로 “PPS-CF까지 충분하다”는 포괄적 결론을 내릴 수 없다. 제조사 수치가 이번 시편의 실제 보증값이라는 뜻도 아니다. [E10]

PEEK-CF·PPA-CF를 포함한다고 해도 반드시 모두 250 MPa 이하라는 뜻은 아니다. 연속섬유·특수 강화재, 더 큰 단면, 다른 시험환경·높은 강도 grade는 별도 범위다. 사용자의 “모든 엔지니어링 재료” 요구는 **재료/grade 목록과 최대 하중·치수·신율·시험속도의 명시된 범위**로 구체화한다.

## 5. 10 kN급 힘과 저하중 정확도를 함께 확보하기

10 kN 부근 파단시험을 할 센서도 연한 재료의 작은 힘을 정확히 읽는지는 별도다. ISO 7500-1 class 1을 만족하는 **검증된 하한~상한 범위**가 필요하며 정격만으로 하한을 추정하지 않는다. 표시기·증폭기·ADC·필터·체결·노이즈를 포함한 장착계 전체가 대상이다. 제조사의 교정 범위가 넓다는 설명을 임의 DIY 센서에 전용하지 않는다. [E11]

ISO E 구간 ε=0.0005–0.0025에 대해 σ=Eε로 단순 선형 계산하면:

| 탄성률 가정 | A=40 mm²의 힘 구간 | A=10 mm²의 힘 구간 |
|---:|---:|---:|
| 1.5 GPa | 30–150 N | 7.5–37.5 N |
| 20 GPa | 400–2000 N | 100–500 N |

2 tf≈19.6 kN 센서에서 30 N는 정격의 약 0.153%, 7.5 N는 약 0.038%다. class 1의 지시오차 1%만 예로 들면 각각 ±0.3 N, ±0.075 N 수준이다. 이는 전체 class 판정의 충분조건이 아니다. 고하중 계측만 교정하고 이 작은 힘까지 class 1이라 주장하지 않는다. 반대로 대용량 센서라는 이유만으로 무조건 실패한다고 단정하지도 않는다. 검증된 범위가 결정한다.

실무적으로는 **교체식 500 kgf급(약 4.9 kN) + 2 tf급(약 19.6 kN)** 계측계를 검토할 수 있다. 각 센서의 실제 교정 하한과 시험 중 최대 힘을 맞춘다. 아주 작은 최대 힘만 발생하는 별도 시험에는 100 N급 소형 센서도 선택지다. 100 N 센서로 150 N E 구간이나 수백 N 파단시험을 수행할 수 없으며, 범위를 초과할 가능성이 있으면 사용하지 않는다. 센서 교체 때마다 체결·정렬·영점·교정 매핑을 기록한다. 이 제안은 정확도/용량 설계용이며 기존 예산 안에 모두 포함된다는 약속은 아니다.

## 6. 높은 탄성률에도 시편 표점 신율계가 필요

E=1.5 GPa와 20 GPa 모두 변형률 0.05–0.25%의 **같은 신율 구간**을 측정한다. 50 mm 표점에서는 ΔL=25–125 µm, 75 mm에서는 37.5–187.5 µm다. 탄성률이 높다고 스텝/크로스헤드 이동이 표점 신율로 바뀌지 않는다. 프레임·그립·탭의 유연성, 미끄럼, 편심 굽힘이 여전히 섞인다.

접촉 신율계와 동등 정확도의 비접촉 광학계 모두 선택지다. **광학만 유일하게 허용되는 것은 아니다.** 이 기계가 카메라 방식을 선택하면 50/75 mm 표점의 µm 수준 정확도를 길이 기준·렌즈/화면 왜곡·초점·카메라 강성·추적·양면 굽힘 영향까지 검증해야 한다. 픽셀수·24 bit ADC·스텝 분해능은 측정 정확도 증거가 아니다. 정확도를 검증하지 못하면 E 수치를 ISO 물성으로 보고하지 않고 힘·실측 단면 기반 비교강도와 제한을 보고한다. 기존 `iso.md`의 527-1 §5.1.5.1 근거를 따른다.

## 출처와 접근 수준

- E1 [ISO 527-2:2025 공식 카탈로그](https://www.iso.org/standard/527-2), [공개 범위](https://www.evs.ee/en/iso-527-2-2025): short fibres 충전·강화재 포함. AM에 대한 적합 절차 전체를 보증하는 자료는 아님.
- E2 [ISO 527-4:2023 공식 카탈로그](https://www.iso.org/standard/85809.html): 2021판 대체, 섬유/복합재 범위 및 사출 예외 주석.
- E3 [ISO 527-5:2021 공식 카탈로그](https://www.iso.org/standard/80370.html): UD 복합재 범위, 다방향 층상 재료 구분.
- E4 [ISO/ASTM 52924:2023](https://www.iso.org/standard/76909.html), [52927:2024](https://www.iso.org/standard/81802.html?browse=tc), [ISO 17295:2023](https://www.iso.org/standard/76471.html?browse=tc): AM 관련 현재 문서. 전문 적합성 검증은 미수행.
- E5 [ISO 1110:2019 공식 카탈로그](https://www.iso.org/standard/76395.html): 2024 확인, 충전 PA 포함 범위와 가속 상태의 한계.
- E6 [ISO 16396-2:2022 공식 카탈로그](https://www.iso.org/standard/80312.html?browse=ics), [합법적 공개 미리보기](https://cdn.standards.iteh.ai/samples/80312/cf02ae18bc37423f89889023fdc6e520/ISO-16396-2-2022.pdf): §4.1·5.1–5.3 확인. FFF 시편 전체의 자동 적용을 주장하지 않음.
- E7 [ISO 15512:2019 공식 카탈로그](https://www.iso.org/standard/73834.html?browse=tc): 2024 확인, 수분 함량과 흡수 시험 구분. 방법별 전체 적용 조건 미검증.
- E8 [ISO 20753:2023](https://www.iso.org/standard/83642.html), [최종판 공개 미리보기](https://cdn.standards.iteh.ai/samples/83642/3f31c860b40e4957b873a9fabbf2153d/ISO-20753-2023.pdf): §6.1 Axy. [2023 FDIS 공개 표](https://cdn.standards.iteh.ai/samples/83642/2a6a5695da0547d79803b19255cbfdc7/ISO-FDIS-20753.pdf)의 1:2 표기는 참고이며 최종 제작 치수 승인에 사용하지 않음.
- E9 [ZwickRoell 현재 ISO 527 설명](https://www.zwickroell.com/industries/plastics/thermoplastics-and-thermosetting-molding-materials/tensile-test-iso-527-1-2/): A22/A25, CW 용도, 계측과 범위. 제조사 해설.
- E10 [Bambu PPS-CF 공식 페이지](https://us.store.bambulab.com/collections/bambu-lab-3d-printer-filament/products/pps-cf): 인장 87±5 MPa 예시. 굽힘 수치와 분리해 사용. 이번 출력물 보증값이나 보편 PPS-CF 값이 아님.
- E11 [ISO 7500-1:2018](https://www.iso.org/standard/72572.html), [Xforce K 제조사 계측범위 설명](https://www.zwickroell.com/fileadmin/content/Files/SharePoint/user_upload/PI_EN/03_677_Xforce_K_load_cells_PI_EN.pdf): 범위별 class 개념. 특정 DIY 로드셀/기계의 class 인증자료는 아님.

고강도 재료의 TDS와 실제 파단하중, 센서 교정 하한, 현재 최종 시편표·축소 Annex A는 후속 검증 항목으로 남는다. 10/15 kN 구조 및 예산 충족을 이 조사 보고서가 입증하지 않는다.
