mk0000001/Open-Pull-Profile/profile/domestic-v0.2/renders/right.png

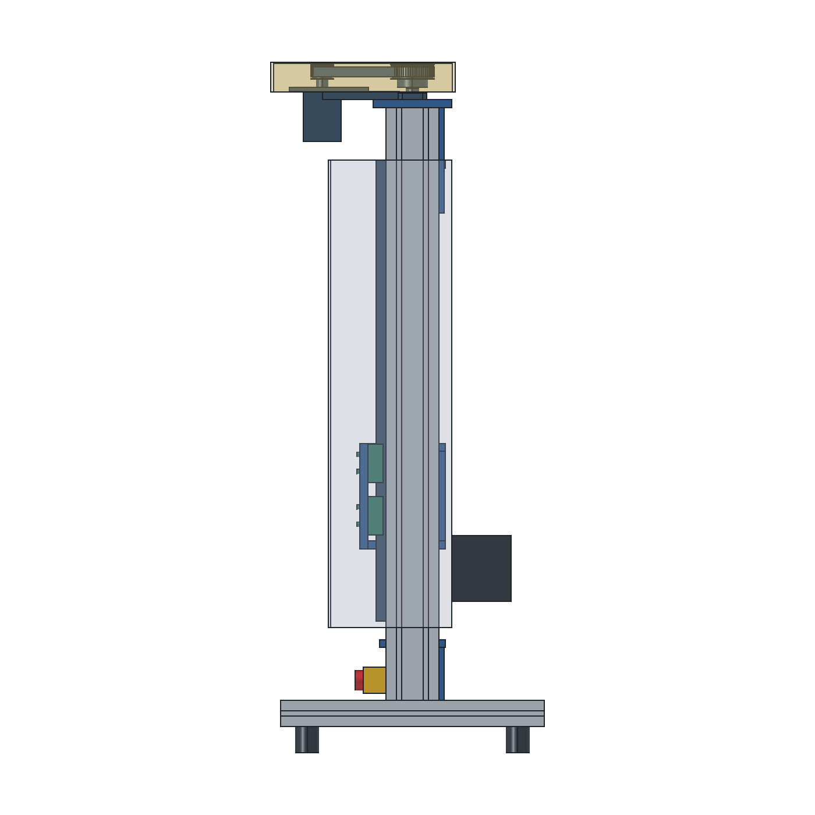
profile/domestic-v0.2/renders/right.png
