mk0000001/Open-Pull-Profile/profile/study-v0.4/renders/Engineering_10kN_room_temperature_study.png

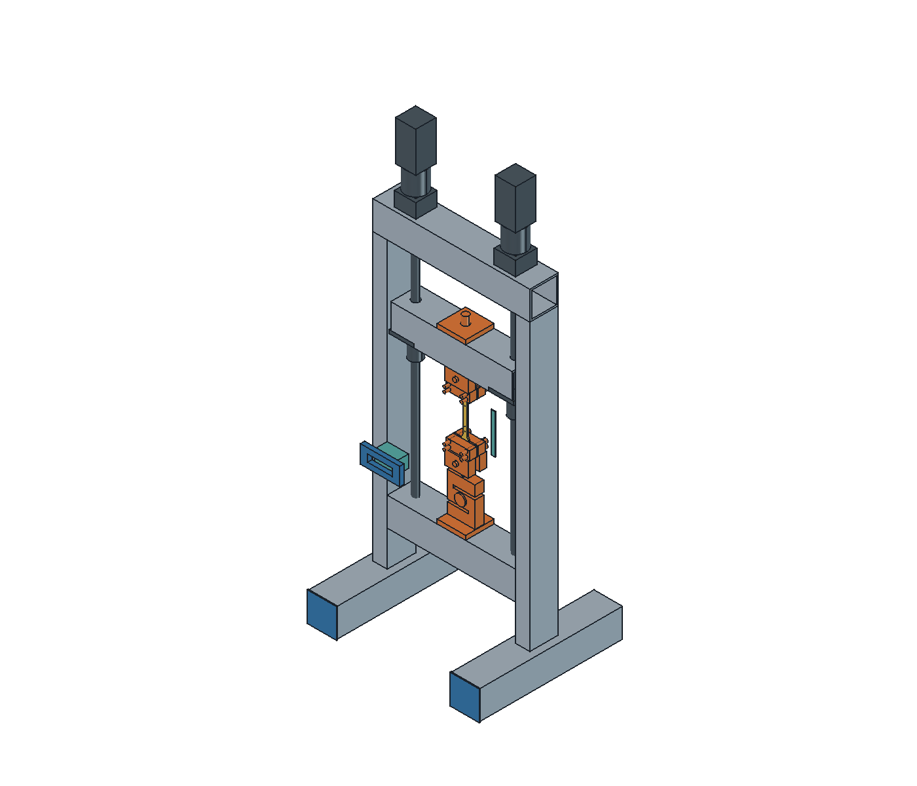
profile/study-v0.4/renders/Engineering_10kN_room_temperature_study.png
