mk0000001/Open-Pull-Profile/profile/study-v0.4/renders/MT02_source_derived_layout.png

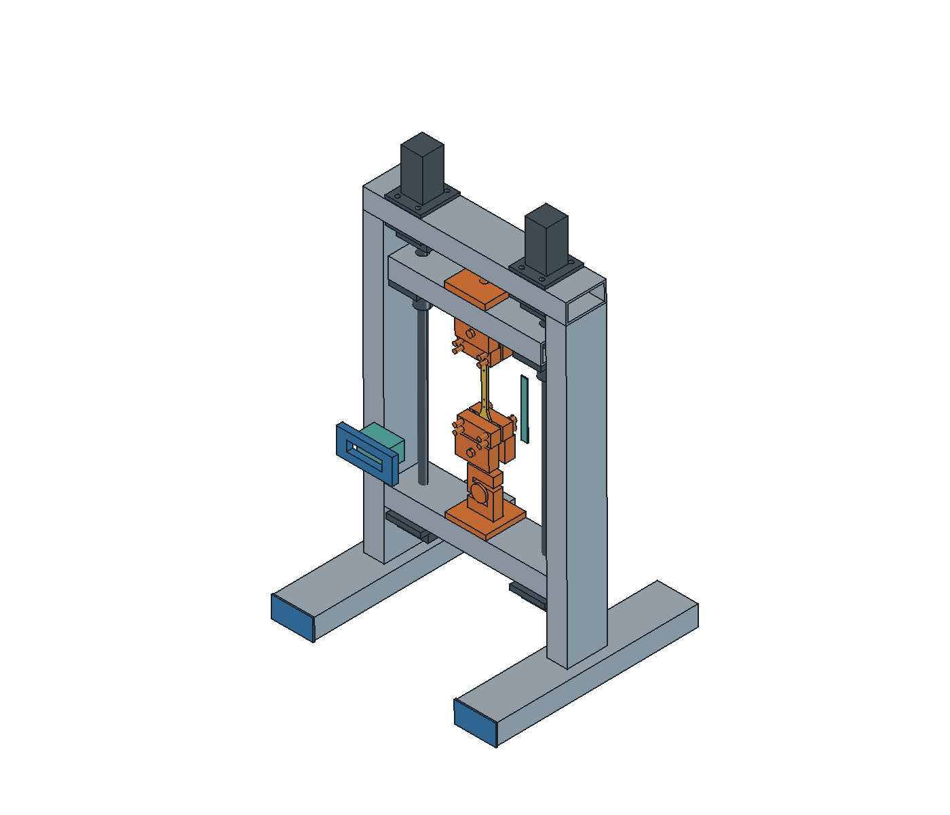
profile/study-v0.4/renders/MT02_source_derived_layout.png
