mk0000001/Open-Pull-Profile/profile/SOURCING.ko.md

# 부품 소싱 — 2026-10-24 검토

**이번 목록은 구매 후보와 옵션 점검표다. 주문·견적 문의는 실행하지 않았다.**

추가 실조회: 국내4080의900mm 옵션28,710원/개, 카스몰 SBA-500L 옵션198,000원을 확인했다. 실제 규격 불일치가 있으므로 전체 발주 판정은 [조립 검증의 보류](ASSEMBLY_AUDIT.ko.md)를 따른다.

구매 경로는 프로파일/절단판을 국내 전문점에서, 전자부품을 쿠팡에서 우선 비교하고, 볼스크류·가이드를 알리에서 같은 판매자의 호환 세트로 조달하는 방향을 추천한다. 쿠팡 입점만으로 국내 재고나 로켓배송을 의미하지 않는다.

페이지를 확인한 날짜와 판매가의 시점은 다를 수 있다. 쿠팡 검색 자료에 과거 도착일이 나타났고 일부 직접 접속은403이었다. 아래 표시 금액을 오늘의 확정 가격으로 쓰지 않았다. 상품이 여러 용량/길이를 한 페이지에 묶은 경우 최저 옵션 가격은 해당 설계 규격 가격이 아니다.

| 부품/필요 옵션 | 우선 후보 | 확인 상태와 판단 |
|---|---|---|
| 4080: 900×2 + 420×4, 총3.48m | [영진 4080 실버](https://www.yjprofile.co.kr/goods/goods_view.php?goodsNo=1000000051) | 실제801~900 옵션 선택28,710원/개.401~500 옵션 표시로420은15,950원/개 계산.4080 소계121,220원. 세부길이/수량 필수 입력. 홈 폭·단면도/I값·끝면 가공은 미확정. |
| 4040: 400×2 | [영진 4040 실버](https://www.yjprofile.co.kr/goods/goods_view.php?goodsNo=1000000046) | 상품 페이지 확인. 동일 업체의 브라켓·홈 너트로 계열을 맞추는 편이 낫다. |
| 프로파일 대안 | [미스미 4060/4080 계열](https://kr.misumi-ec.com/vona2/detail/110310158669/) | 제조사 카탈로그 후보. 실제 길이·형번 옵션과 배송비로 다시 비교해야 한다. |
| 판재: 8/12mm, 목록 별첨 | [제일알루미늄 원·부자재](https://www.jeilal.com/bbs/content.php?co_id=03_01) | 6061 등 판재 절단 판매와 8~65T 취급을 확인. 6061-T6 조질, 소량 절단·홀 가공 여부는 미확정. 최종 도면 전 가공 발주 금지. |
| SFU1605 두 축, 900 후보 + BK12/BF12 각2 + 너트 하우징2 | [알리 규격 검색](https://www.aliexpress.com/w/wholesale-SFU1605-900mm-BK12-BF12.html) | 검색 링크이며 선정 상품이 아니다. 전체길이900/나사부900 혼동, 좌우 끝단 동일 가공, 베어링 축하중, 단방향/양방향 정격을 확인한다. |
| 볼스크류 개별 상품 탐색 후보 | [알리 item 1005007307289846](https://www.aliexpress.com/item/1005007307289846.html) | 외부 검색 색인에 SFU1605 등 복수 규격 상품으로 잡힘. 알리 원문 직접 확인 불가. **900 옵션·세트 내용·재고·가격 미확인, 구매 추천 확정 아님.** |
| HGR15 700×2 + HGH15CA 블록4 | [알리 규격 검색](https://www.aliexpress.com/w/wholesale-HGR15-700mm-4-blocks.html) | 같은 판매자/같은 레일 계열의 세트 도면 필요. 이름만 유사한 MGN15와 혼합하지 않는다. |
| 가이드의 쿠팡 탐색 후보 | [쿠팡 HGR15](https://www.coupang.com/vp/products/8600585164) | 검색 제목은460mm였다. **이번700mm 규격과 달라 바로 주문할 대상이 아니다.** 원문403으로 옵션 미확인. |
| S형 인장 로드셀500kgf | [쿠팡 PUSHTON S형](https://www.coupang.com/vp/products/9246574572) | 검색 자료 표시43,600원, 여러 용량 혼합. **500kg 옵션 가격·탭·교정 성적서 미확인.** 직접 접근403. 쿠팡 해외 구매대행 여부 확인 필요. |
| 로드셀의 국내 대안 | [CAS SBA 제조사](https://www.cas.co.kr/integration/read.jsp?code=20200813f2610ff062&no=115&reqPageNo=1), [국내 판매 후보](https://tstshop.co.kr/product/cas-%EC%B9%B4%EC%8A%A4%EC%A0%84%EC%9E%90%EC%A0%80%EC%9A%B8-%EC%9D%B8%EC%9E%A5%ED%98%95-%EB%A1%9C%EB%93%9C%EC%85%80-sba-series-sba-25l-5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) | 제조사에서 인장/재료시험기 용도를 확인. 판매 페이지 기본 표시140,800원, 용량 옵션 미선택. SBA-500L의 가격·외형·M12 여부·액세서리를 별도 확인한다. |
| 로드셀의 옵션 확인 후보 | [카스몰 SBA-500L](https://cas-mall.com/goods/goods_view.php?goodsNo=1000000249) |500L 옵션 실제 선택1개198,000원. 공식 자료의200kgf~1tf 액세서리 나사 M12×1.75 확인. 외형·로드엔드·그립 전환 어댑터는 별도 설계 필요. |
| 저가 로드셀 알리 탐색 후보 | [알리 item 1005005915852645](https://www.aliexpress.com/item/1005005915852645.html) | 외부 색인상 S형 다중 용량 상품. 원문/500kg 옵션 확인 불가. 정확도·탭·교정 이력 확보 전 채택 미정. |
| HX711 모듈1개 | [쿠팡 스마트포커스](https://www.coupang.com/vp/products/8941551676) | 상품 페이지 표시880원+배송3,000원. 과거 도착일 노출로 최신 재고/금액 미확인. 80SPS 전환 가능 여부, 출력 센서와 전압 호환 확인. |
| NEMA23 약2~3Nm 1개 | [쿠팡 검색](https://www.coupang.com/np/search?q=NEMA23%203Nm), [알리 검색](https://www.aliexpress.com/w/wholesale-NEMA23-3Nm-stepper-motor.html) | 검색 링크만 제공. 57각, 축8mm, 모터길이112 이하 공간 가정. 토크-속도 곡선·상전류·축길이·드라이버 호환과 낙하 방지 방식 확정 전 구매 보류. |
| DM542급 드라이버1개 | [쿠팡 모터베이 DM542](https://www.coupang.com/vp/products/7796163351) | 상품 제목과 판매자 검색 자료 확인, 직접 페이지 불가. 피크/RMS 전류, 입력광커플러 전압, 모터 상전류에 맞게 실제 모델 선정. |
| HTD5M 20T×1/40T×2, 폭15 + 920-5M-15 벨트 | [쿠팡20T 후보](https://www.coupang.com/vp/products/8677758567), [알리 벨트 검색](https://www.aliexpress.com/w/wholesale-920-5M-15-timing-belt.html) | 풀리 후보는 해외 구매대행 표기. 20T는모터8mm축,40T는실제 나사 끝단 보어에 맞춘다. CAD 순수 피치길이920mm, 모터 Y=-137.049mm. 플랜지·치형·제조 공차·텐셔너 여유는 추가 검토한다. |
| MCU/24V PSU/스위치·함체 | [쿠팡 Nano 검색](https://www.coupang.com/np/search?q=Arduino%20Nano%20ATmega328P), [쿠팡24V 검색](https://www.coupang.com/np/search?q=24V%2010A%20SMPS) | 검색 링크. 기존Nano와 다른 Nano Every/33계열을 무심코 대체하지 않는다. AC 배선·접지·퓨즈·전장함 포함 견적. |
| 차폐/비상정지/리미트/낙하 방지 | [쿠팡 PC판 검색](https://www.coupang.com/np/search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), [쿠팡 비상정지 검색](https://www.coupang.com/np/search?q=%EB%B9%84%EC%83%81%EC%A0%95%EC%A7%80%20NC) | 검색 링크. CAD는4mm PC 공간만 제시한다. 낙하 포획/브레이크는 상품 미선정. 기본 BOM에 누락하지 않았다. |

## 예산 틀 — 판매자 견적이 아닌 작성자 추산

| 묶음 | 예상 범위(원) |
|---|---:|
| 절단 프로파일 | 135,000–180,000 |
| 판재·어댑터 절단/가공 | 150,000–300,000 |
| 두 볼스크류·너트·지지대 | 100,000–180,000 |
| 두 레일·네 블록 | 60,000–120,000 |
| 모터·드라이버 | 80,000–150,000 |
| 벨트·풀리·텐셔너 | 25,000–60,000 |
| 국내 CAS SBA-500L 센서 | 198,000 |
| MCU·ADC·PSU·배선 | 60,000–100,000 |
| 차폐·비상정지·리미트·낙하 방지 | 60,000–180,000 |
| 체결부품·브라켓·조절발 | 40,000–80,000 |
| **합계(국내 센서 기준)** | **908,000–1,548,000** |

배송·세금·공구·그립 금속 제작·전문 교정 및 센서 액세서리 비용은 별도다. 기성 부품 가격보다 **한 대 분량 판재 가공비**가 크게 달라질 가능성이 있다. 이 비용으로 구매 확정하지 않고, v0.2 가공도 확정 후 견적을 받는다. 이 범위는 초기에 제시한 저가 센서/프로파일 추산을 실제 옵션 조사로 수정한 값이다.

## 추천 구매 순서

1. 프로파일 단면도/홈 규격, SFU1605 끝단·BK/BF 도면, 레일 도면, S형500kg 센서 도면을 확보한다. 현재 대체안 중 하나를 먼저 고른다.
2. 그 도면으로 FreeCAD 연결부와 가공도, 낙하 방지 방식을 확정한다.
3. 프레임·금속 연결부 견적을 먼저 합산한 뒤, 정밀 부품을 같은 규격 세트로 발주한다.
4. 체결·원점·무부하 이동 확인 후 센서를 교정한다. 작은 시편부터 실제 반복성/파손·미끄럼을 확인한다.

검색 결과의460mm 레일,20kg 싱글포인트 로드셀,150mm 소형 슬라이드 같은 유사 상품을 이 설계의 대체품으로 주문하지 않는다.
