mk0000001/Open-Pull-Profile/profile/domestic-v0.2/SOURCING.ko.md

# 국내 판매 기준 소싱 비교 — 2026-10-24

결론: **프레임은 국내 절단 전문점과 쿠팡을 비교하고, 볼스크루·지지대·가이드는 정확한 도면이 있는 한국미스미 경제형을 기준으로 삼는 조합**이 현재 가장 검토하기 쉽다. 미스미가 무조건 더 비싸다고 가정하지 않는다. 가격 미공개 품목은 견적 미확정이며 0원으로 합산하지 않았다. 주문·장바구니 추가·판매자 연락은 하지 않았다.

## 프로파일: 쿠팡에서도 살 수 있다

| 국내 판매 경로 | 확인된 가격/옵션 | 이번 설계에 적용하는 조건 |
|---|---|---|
| [쿠팡 동원테크4080](https://www.coupang.com/vp/products/8528493043) | **100mm 4,080원**, 배송4,000원, 로젠택배: 검색에 저장된 상품 정보 | 국내 택배 판매 후보. 쿠팡 직접 열기는403, 최신 결제 화면·900/420mm 절단 옵션·단면 도면 미확인. 100mm 가격을9배해서 확정 견적이라고 쓰지 않음 |
| [쿠팡 와이에스테크 규격/절단 선택](https://www.coupang.com/vp/products/6215203988) | 검색 정보4080블랙100mm5,000원, 배송4,000원 | 기본 옵션·색상별 가격이 다름. 국내 판매자/CJ 배송 후보이나 최종 필요 옵션·홈 규격·재고 재확인 |
| [YJ 경희4080실버](https://www.yjprofile.co.kr/goods/goods_view.php?goodsNo=1000000051) | **900mm28,710원**, **420mm15,950원**. 기본80원+구간 추가금28,630/15,870 | 실옵션과 필수 절단길이 입력 확인. 900×2+420×4=**121,220원**, 배송·구멍가공 별도 |
| [YJ 경희4040실버](https://www.yjprofile.co.kr/goods/goods_view.php?goodsNo=1000000046) | 301~400mm 옵션 추가7,840원+기본80=**400mm7,920원** | 400×2=15,840원. 프로파일8개 총 **137,060원**, 배송·추가가공 별도. 4040가격은 현재 옵션HTML을 읽어 계산, 결제 견적 아님 |
| [한국미스미 HFS8-4080](https://kr.misumi-ec.com/vona2/detail/110302690310/), [공식 도면](https://kr.misumi-ec.com/pdf/fa/2015/p2_0659.pdf) | HFS8-4080-900×2, -420×4 기준 견적. 4040-400×2도 별도 견적 | 국내 정식 판매 경로. 지정길이 가격은 공개 화면에서 확정 못함. 일본 엔화표/과거 카탈로그 가격을 원화 견적으로 쓰지 않음 |

**동일 단면 비교가 먼저다.** HFS8-4080은 ‘8시리즈’지만 실제 홈 폭은10mm, 홈 간격40mm, 코어홀10.5mm다. 쿠팡·국내4080이 이를 그대로 따른다고 가정하지 않는다. 프로파일/호환 너트/브래킷을 같은 단면 계열로 묶고, 재질·중량·단면2차모멘트·절단 직각도·길이 공차·필요한 축 통과 구멍 가공까지 확인한 뒤 결정한다. 경량/중량 프로파일도 같은 품목으로 가격 비교하지 않는다. 일반 프로파일 면에 가이드를 바로 달아 정밀 평행도가 확보된다고 보지 않는다.

필요 절단표는4080 900mm2개,420mm4개 /4040 400mm2개다. 쿠팡에는 이8개와 호환 부속, 배송·가공을 합한 실제 옵션 합계가 확보되면 비교할 수 있다. 현재는 쿠팡이 최저가라고 확정할 근거가 없다.

## 구동·계측 국내품 선정표

| 품목/수량 | 도면 기준 국내 판매품 | 현재 가격 근거 | 쿠팡/저가 대안 판단 |
|---|---|---|---|
| 모터1 | [Leadshine57CM23-3A, 옵션P0000CGZ000D](https://motiongearon.com/product/detail.html?product_no=1533) | **42,900원**+배송3,500, VAT 별도 표기 없음. 실판매 옵션 확인, 실재고 수량 보증 아님 | [쿠팡 Scipia CIC57100](https://www.coupang.com/vp/products/8550726815?itemId=603332816&vendorItemId=4581242864)44,700원 검색가. 제조사OEM, 축길이20/23 표기 충돌 → CAD 기준 제외 |
| 드라이버1 | [정품 LeadshineEM542S 국내 WITHFA](https://www.withfa.co.kr/stepper-motor/leadshine), [Motor114](https://leadshine.co.kr/product/view.php?pcode=PROD00000000051) | **국내 견적 필요**. 제조사 전류/전압/입력 매뉴얼 확보, 현지 실재고 미확정 | [쿠팡 OEM A7Q DM542](https://www.coupang.com/vp/products/1432305817?itemId=2473811862&vendorItemId=70467187979)29,800원 검색가. 정품 Leadshine 사양을 대신 적용할 수 없어 보류 |
| 볼스크루2 | [C-TBSE1505-861](https://kr.misumi-ec.com/vona2/detail/110310435959/?HissuCode=C-TBSE1505-861) | 정확한861 품번 주문인식 확인, **금액 견적 필요** | 국내 Mizo 저가품은 현재 품절. 쿠팡 SFU1605는 국내재고·제조사·같은 끝가공 확인 못해 미채택 |
| 고정지지2 | [C-TFK12](https://kr.misumi-ec.com/vona2/detail/110310392219/?HissuCode=C-TFK12) | 개당20,364원 VAT별도 | C-TBSE에 맞는 조합. 다른 HIWIN/무브랜드 FK 정격을 빌려 쓰지 않음 |
| 부동지지2 | [C-TFF12](https://kr.misumi-ec.com/vona2/detail/110310392309/?HissuCode=C-TFF12) | 개당5,726원 VAT별도 | 지지대4개 합52,180원+VAT=**57,398원** |
| 레일2/블록4 | [E-HLGH15-700-B2×2](https://kr.misumi-ec.com/vona2/detail/110311122029/?HissuCode=E-HLGH15-700-B2) | 정확한700/B2 품번 주문인식 확인, **세트 견적 필요** | 국내 HIWIN 판매 대안은820레일2+블록4=267,000원(배송/VAT별도 확인). 쿠팡 동명이품의 국내재고·정품 확인 불가 |
| 풀리1+2 | [HTPA20S5M150-A-P8](https://kr.misumi-ec.com/vona2/detail/110300406030/?HissuCode=HTPA20S5M150-A-P8), [40T/P10](https://kr.misumi-ec.com/vona2/detail/110300406030/?HissuCode=HTPA40S5M150-A-P10) | **형번별 견적 필요** | 모두 S5M으로 통일. HTD5M 혼용 금지. 축 고정 토크·허브물림·오버행은 설계 보류 |
| 벨트 사용1 | [C-HTBN920S5M-150](https://kr.misumi-ec.com/vona2/detail/110310459629/?HissuCode=C-HTBN920S5M-150) | **8,593원 VAT포함/개**. 설명상 최소4개 주문 가능성 → 실제 주문금액34,372원일 수 있음 | 국내 정식 판매 경로. 재고 라벨/판매가능과 국내 물리 재고 수량은 구분 |
| 로드셀1 | [카스몰 SBA-500L 옵션](https://cas-mall.com/goods/goods_view.php?goodsNo=1000000249) | **198,000원**, 배송0. 같은 모델 디바이스마트도198,000원 VAT포함 | 쿠팡 무브랜드500kg 제품은 제조사/도면/배송이 불분명. 센서정격500kgf≠장비2kN 허용하중 |
| 로드엔드 후보2 | [THK NOS12T](https://www.wjbearingmall.com/goods/goods_view.php?goodsNo=1000003150) |14,520원 표시. [미스미E-GZW12](https://kr.misumi-ec.com/vona2/detail/110310557009/?HissuCode=E-GZW12)는3,696원 VAT포함 기준값, 세일종료 정보/한국판 전체도면 재확인 | 실제 센서 탭깊이·물림·금속클레비스/핀 미확정. 현재 CAD에 연결 완료 부품으로 넣지 않음 |

이 표의 가격은 VAT 기준을 열에 적은 대로 유지한다. **완성 장비 총액은 아직 산출할 수 없다.** 볼스크루·레일·풀리·드라이버 견적과 금속판/그립 어댑터, 브레이크/포획, 가드/전장/교정 비용이 빠져 있기 때문이다. 이전 v0.1의91~155만원 범위도 이 부품표의 견적 합계가 아니다.

## 저가여도 제외한 경우

- 미스미C-57STM04는38,579원 VAT별도이나 **수주 정지** 배너가 있어 제외. 오래된 출하1일 표를 우선하지 않는다.
- Mizo SFU1605/지지대 세트는 국내 판매 페이지가 있어도 **현재 품절**.
- 쿠팡 인장지그10만원은 모델·정격·체결치수 미표기. IMADA PGC-2530 국내916,700원은 상부용 제한이 있어2개 한쌍으로 선정하지 않는다.
- 해외배송·구매대행 제품을 국내 재고 대안으로 합산하지 않았다. 정밀부품은 한국 판매사라도 출고국/납기를 따로 확인해야 한다.

다음 설계 판단은 가격이 아니라 남은 장착부 확정이다: 센서/그립 금속 어댑터, FK 허용축하중, 풀리 체결, 프레임 단면·모든 너트/브래킷, 낙하 포획/전장 차단. 이 항목이 닫히기 전에는 이 표로 일괄 주문하지 않는다.

벨트 경로의 추가 보류: 모터 감김각72.50°/이물림4.03개. 제조사 기준 정격 보정 또는 아이들러/경로 변경을 검토한다. 현재 풀리·벨트는 구매 후보 외형으로 배치했으며 전달 용량 승인이 아니다. 근거와 계산값은 README/PARTS/VALIDATION에 기록했다.
