mk0000001/Open-Pull-Profile/profile/build-v0.3/printed-candidates/BeamFacingBottomLeftFront.stl

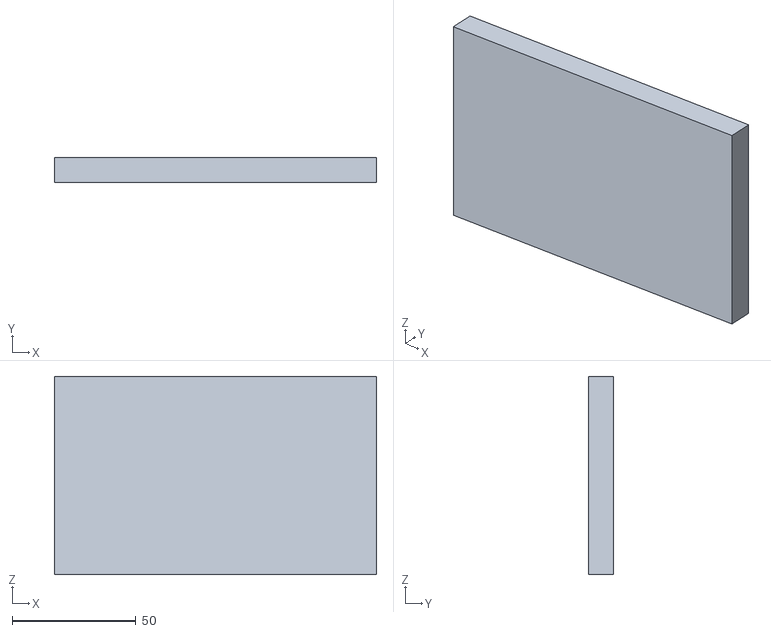
[picture p8: CAD file, 2026-10-24]
profile/build-v0.3/printed-candidates/BeamFacingBottomLeftFront.stl
130.0 x 10.0 x 80.0
