mk0000001/Open-Pull-Profile/profile/build-v0.3/printed-candidates/printed-frame/ColumnLeftModule1.stl

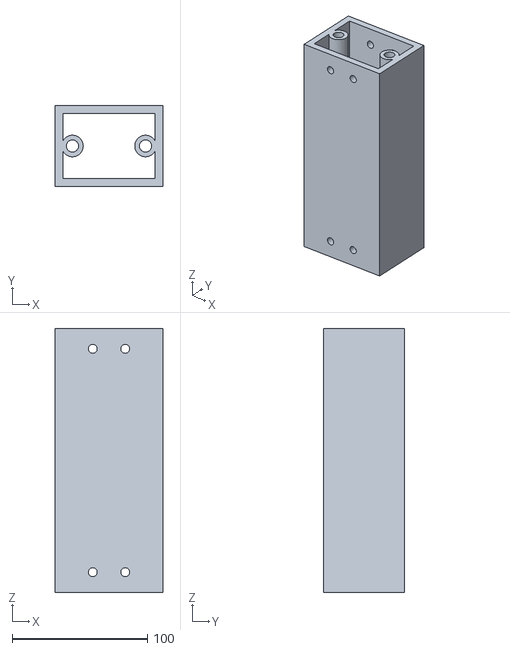
[picture p9: CAD file, 2026-10-24]
profile/build-v0.3/printed-candidates/printed-frame/ColumnLeftModule1.stl
80.0 x 60.0 x 195.0
