mk0000001/Open-Pull-Profile/profile/build-v0.3/printed-candidates/rod-reinforced/SpliceLeft1Front.stl

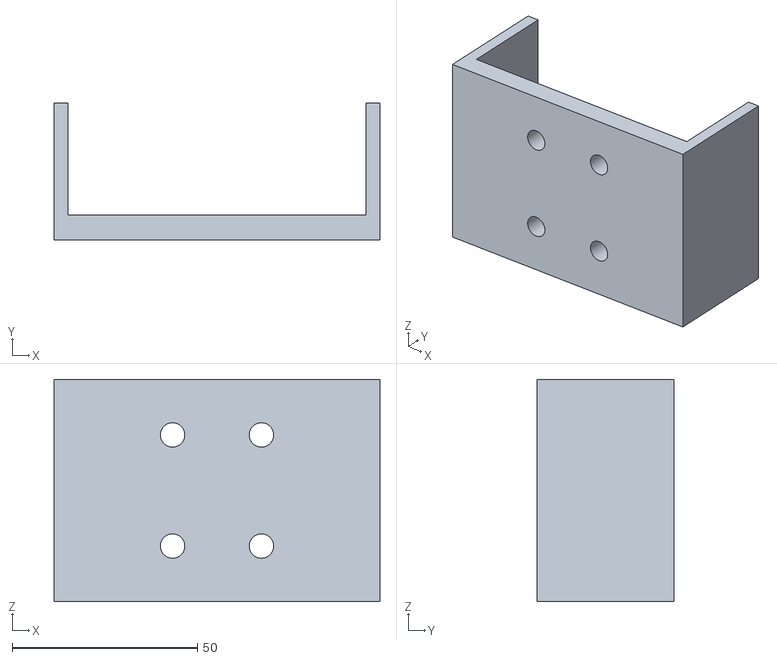
[picture p10: CAD file, 2026-10-24]
profile/build-v0.3/printed-candidates/rod-reinforced/SpliceLeft1Front.stl
88.0 x 37.0 x 60.0
