mk0000001/Open-Pull-Profile/profile/cad/OpenPull_Profile_v0.1.0-design.step

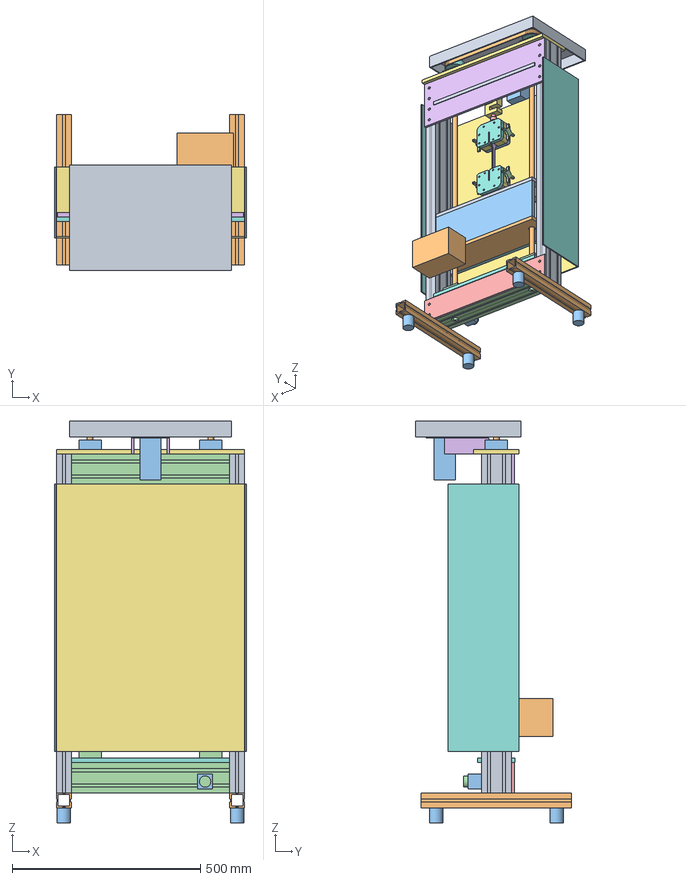
[picture p11: CAD file, 2026-10-24]
profile/cad/OpenPull_Profile_v0.1.0-design.step
510.0 x 415.0 x 1067.0 mm
EX-ColumnLeft | 4080 column 900
EX-BaseLeft | 4040 base skid 400
FT | Levelling foot envelope
FT | Levelling foot envelope001
EX-ColumnRight | 4080 column 900
EX-BaseRight | 4040 base skid 400
FT | Levelling foot envelope002
FT | Levelling foot envelope003
EX-LowerBeamFront | 4080 crossmember 420
EX-UpperBeamFront | 4080 crossmember 420
EX-LowerBeamRear | 4080 crossmember 420
EX-UpperBeamRear | 4080 crossmember 420
JP-Lower | Rear joint plate 500x80x8 / bolt layout provisional
JP-Upper | Rear joint plate 500x160x8 / bolt layout provisional
PL-BearingRoof | BearingRoof / hole pattern provisional
PL-FloatingSupportPlate | FloatingSupportPlate / hole pattern provisional
PL-FixedGripPlate | FixedGripPlate / hole pattern provisional
BS-Left | SFU1605 nominal 900 / end machining TBD
BK-Left | BK12 support envelope / actual bearing rating pending
BF-Left | BF12 support envelope / actual bearing rating pending
RG-Left | HGR15 700 / mounting pattern TBD
GB-Left1 | HGH15CA envelope
GB-Left2 | HGH15CA envelope
BN-Left | SFU1605 nut housing envelope / bolt pattern TBD
BS-Right | SFU1605 nominal 900 / end machining TBD
BK-Right | BK12 support envelope / actual bearing rating pending
BF-Right | BF12 support envelope / actual bearing rating pending
RG-Right | HGR15 700 / mounting pattern TBD
GB-Right1 | HGH15CA envelope
GB-Right2 | HGH15CA envelope
BN-Right | SFU1605 nut housing envelope / bolt pattern TBD
CH-01 | Front carriage plate 500x160x12
PL-CrossheadTop | CrossheadTop / hole pattern provisional
PL-CrossheadBottom | CrossheadBottom / hole pattern provisional
CH-04 | Crosshead rear stiffener 400x136x12
AD-L | M8 grip stem / connection detail pending
AD-U | M8 to M12 adapter envelope / verify both threads
AD-T | M12 sensor top stem / connection TBD
CK-LowerGrip | CNC Kitchen original grip / unvalidated load capacity
CK-UpperGrip | CNC Kitchen original grip / unvalidated load capacity
CK-SP | Original specimen reference, not the recommended small starting coupon
LC-01 | S-type 500kgf sensor space / actual dimensions pending
PU-0 | HTD5M 40T / tooth detail omitted
PU-1 | HTD5M 40T / tooth detail omitted
PU-2 | HTD5M 20T / tooth detail omitted
MO-01 | NEMA23 motor envelope / torque curve TBD
MO-S | Motor shaft envelope
PL-MotorMount | MotorMount / hole pattern provisional
MM | Motor bracket side web / detail pending
MM | Motor bracket side web / detail pending001
PC-F | PC front guard envelope 4mm / hinge and latch TBD
PC-Left | PC side guard envelope 4mm
PC-Right | PC side guard envelope 4mm
PC-B | Belt cover envelope / mounting and guarding TBD
EL-BOX | Control enclosure space / wiring design pending
ES-01 | E-stop position / hardwired circuit pending
ES-02 | Emergency stop actuator space
