mk0000001/Open-Pull-Profile/profile/domestic-v0.2/cad/OpenPull_Profile_v0.2.0-interface-review.step

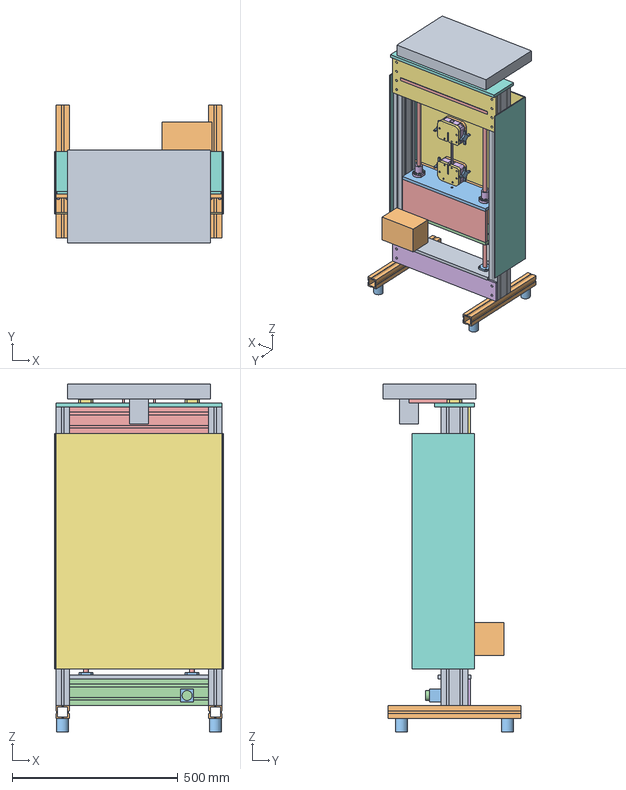
[picture p12: CAD file, 2026-10-24]
profile/domestic-v0.2/cad/OpenPull_Profile_v0.2.0-interface-review.step
510.0 x 415.0 x 1049.0 mm
EX-ColumnLeft | ColumnLeft
EX-BaseLeft | BaseLeft
FT | FootLeft160F
FT | FootLeft160R
EX-ColumnRight | ColumnRight
EX-BaseRight | BaseRight
FT | FootRight160F
FT | FootRight160R
EX-LowerBeamFront | LowerBeamFront
EX-UpperBeamFront | UpperBeamFront
EX-LowerBeamRear | LowerBeamRear
EX-UpperBeamRear | UpperBeamRear
JP-Lower | LowerJointPlate
JP-Upper | UpperJointPlate
PL-BearingRoof | BearingRoof
PL-FloatingSupportPlate | FloatingSupportPlate
CH-01 | CrossheadFront
PL-CrossheadTop | CrossheadTop
PL-CrossheadBottom | CrossheadBottom
CH-04 | CrossheadRear
CK-LowerGrip | LowerGrip
PL-FixedGripPlate | FixedGripPlate
CK-UpperGrip | UpperGrip
CK-SP | Specimen
PC-F | FrontGuard
PC-Left | SideGuardLeft
PC-Right | SideGuardRight
PC-B | BeltCover
EL-BOX | ControlEnclosure
ES-01 | EStopBase
ES-02 | EStopButton
C-TBSE1505-861 | ScrewLeft
ISO4762 M4x16 | FKBoltLeft-15.556349186104045-15.556349186104045
ISO4762 M4x16 | FKBoltLeft-15.55634918610404515.556349186104045
ISO4762 M4x16 | FKBoltLeft15.556349186104045-15.556349186104045
ISO4762 M4x16 | FKBoltLeft15.55634918610404515.556349186104045
C-TFK12 | FKLeft
C-TFK12 supplied collar | FKCollarLeft
C-TFK12 locknut reference | FKLocknutLeft
ISO4762 M4x12 | FFBoltLeft-14.849242404917497-14.849242404917497
ISO4762 M4x12 | FFBoltLeft-14.84924240491749714.849242404917497
ISO4762 M4x12 | FFBoltLeft14.849242404917497-14.849242404917497
ISO4762 M4x12 | FFBoltLeft14.84924240491749714.849242404917497
C-TFF12 | FFLeft
ISO4762 M5x30 | NutBoltLeft45
M5 nut reference | NutFastenerLeft45
ISO4762 M5x30 | NutBoltLeft90
M5 nut reference | NutFastenerLeft90
ISO4762 M5x30 | NutBoltLeft135
M5 nut reference | NutFastenerLeft135
ISO4762 M5x30 | NutBoltLeft225
M5 nut reference | NutFastenerLeft225
ISO4762 M5x30 | NutBoltLeft270
M5 nut reference | NutFastenerLeft270
ISO4762 M5x30 | NutBoltLeft315
M5 nut reference | NutFastenerLeft315
C-TBSE1505-861 supplied nut | NutLeft
C-TBSE1505-861 | ScrewRight
ISO4762 M4x16 | FKBoltRight-15.556349186104045-15.556349186104045
ISO4762 M4x16 | FKBoltRight-15.55634918610404515.556349186104045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
