mk0000001/Open-Pull-Profile/profile/study-v0.4/cad/Engineering_10kN_room_temperature_study.FCStd

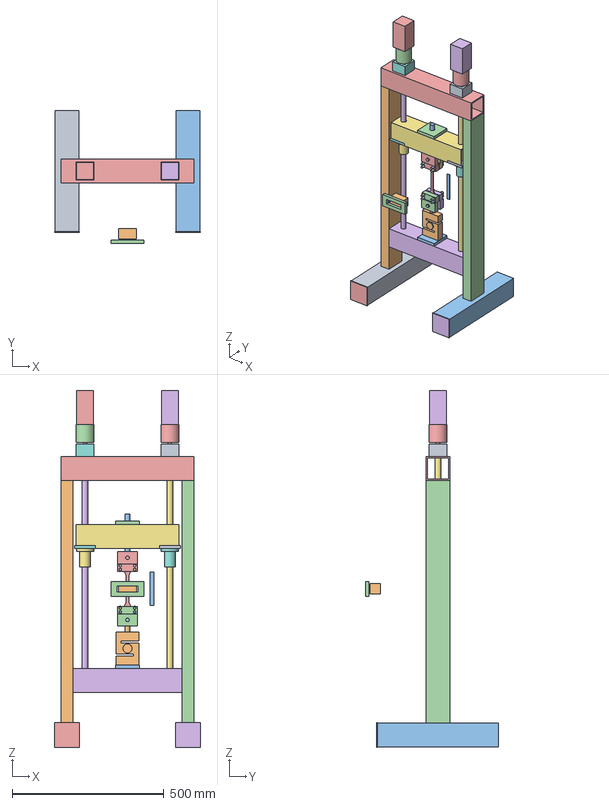
[picture p13: CAD file, 2026-10-24]
profile/study-v0.4/cad/Engineering_10kN_room_temperature_study.FCStd
482.0 x 440.0 x 1178.0 mm
FootLeft
ColumnLeft
FootRight
ColumnRight
TopBeam
BottomBeam
Crosshead
AxialCarrierLeft
Thrust51101Left0
Thrust51101Left1
RadialBearingLeft
Reduction3to1Left
MotorLeft
ScrewLeft
BallNutLeft
NutSpreaderLeft
AxialCarrierRight
Thrust51101Right0
Thrust51101Right1
RadialBearingRight
Reduction3to1Right
MotorRight
ScrewRight
BallNutRight
NutSpreaderRight
LoadCell
LoadCellBaseMount
LowerGripRear
UpperGripRear
LowerGripFront
UpperGripFront
LowerGripPin
LowerClampBolt0
LowerClampBolt1
LowerClampBolt2
LowerClampBolt3
UpperGripPin
UpperClampBolt0
UpperClampBolt1
UpperClampBolt2
UpperClampBolt3
LowerStudEye
UpperStudEye
CentralSpreader
NominalCoupon
Mark75Low
Mark75High
Mark50Low
Mark50High
CameraEnvelope
CalibrationTarget
CameraMount
EndCapLeft
EndCapRight
