mk0000001/Open-Pull-Profile/profile/study-v0.4/print-candidates/Custom_halfscale_85x10x2.stl

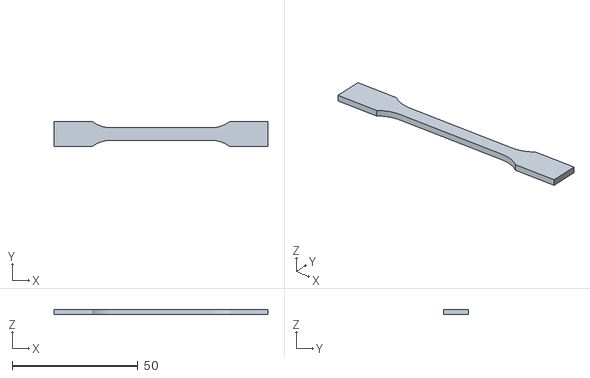
[picture p14: CAD file, 2026-10-24]
profile/study-v0.4/print-candidates/Custom_halfscale_85x10x2.stl
85.0 x 10.0 x 2.00
