mk0000001/Open-Pull-Profile/profile/study-v0.4/utm-derived/UTM_V2_budget_fixture_study.FCStd

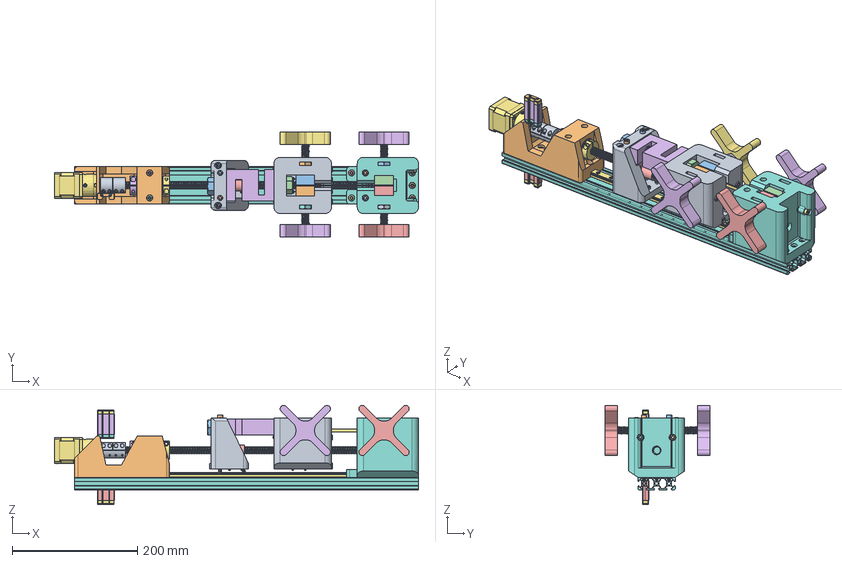
[picture p15: CAD file, 2026-10-24]
profile/study-v0.4/utm-derived/UTM_V2_budget_fixture_study.FCStd
582.3 x 167.5 x 159.0 mm
Moving Grip v40
Grip Block v5
Grip Block v001
Grip Block v002
Grip Block v003
Grip Screw Head v8
Grip Screw Head v001
Stationary Grip Mk3 v37
Moving Load Cell Mount Mk2 v23
Stepper Motor Mount Mk4 Long v11
91310A830
91310A831
T12 Brass Nut v3
Dummy Load Cell v4
Geared Stepper Motor Dummy v3
Dummy 400mm T12 Lead Screw v3
6001-2z v2
6001-2z v001
6001-2z v002
6001-2z v003
6001-2z v004
6001-2z v005
6001-2z v006
6001-2z v007
6001-2z v008
6001-2z v009
6001-2z v010
6001-2z v011
MGN12H, LINEAR GUIDE BLOCK
MGN12H, LINEAR GUIDE BLOCK001
MGN12H, LINEAR GUIDE BLOCK002
MGN12H, LINEAR GUIDE BLOCK003
MGN12H, LINEAR GUIDE BLOCK004
MGN12H, LINEAR GUIDE BLOCK005
MGN12H, LINEAR GUIDE BLOCK006
MGN12H, LINEAR GUIDE BLOCK007
MGN12H, LINEAR GUIDE BLOCK008
MGN12H, LINEAR GUIDE BLOCK010
MGN12H, LINEAR GUIDE BLOCK011
MGN12H, LINEAR GUIDE BLOCK012
MGN12H, LINEAR GUIDE BLOCK013
MGN12H, LINEAR GUIDE BLOCK014
MGN12H, LINEAR GUIDE BLOCK015
MGN12H, LINEAR GUIDE BLOCK016
MGN12H, LINEAR GUIDE BLOCK017
MGN12H, LINEAR GUIDE BLOCK018
MGN12 LINEAR GUIDE RAIL, CONFIGURABLE, 300 mm v3
2060 Aluminium Extrusion European Standard (T6) v3
91290A113
91290A114
91290A115
91290A116
91290A117
91290A118
91290A119
91290A120
91290A121
91290A122
91290A123
91290A124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
