mk0000001/Open-Pull-Profile/profile/build-v0.3/printed-candidates/CrossheadPadUpperLeft.stl

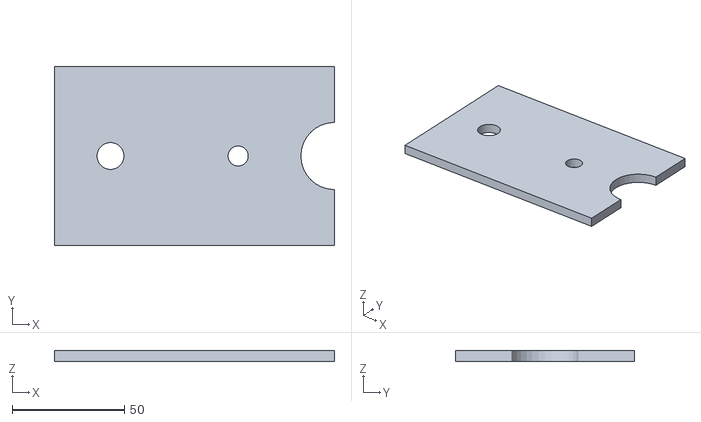
[picture p17: CAD file, 2026-10-24]
profile/build-v0.3/printed-candidates/CrossheadPadUpperLeft.stl
125.0 x 80.0 x 5.00
