mk0000001/Open-Pull-Profile/profile/study-v0.4/cad/MT02_source_derived_layout.FCStd

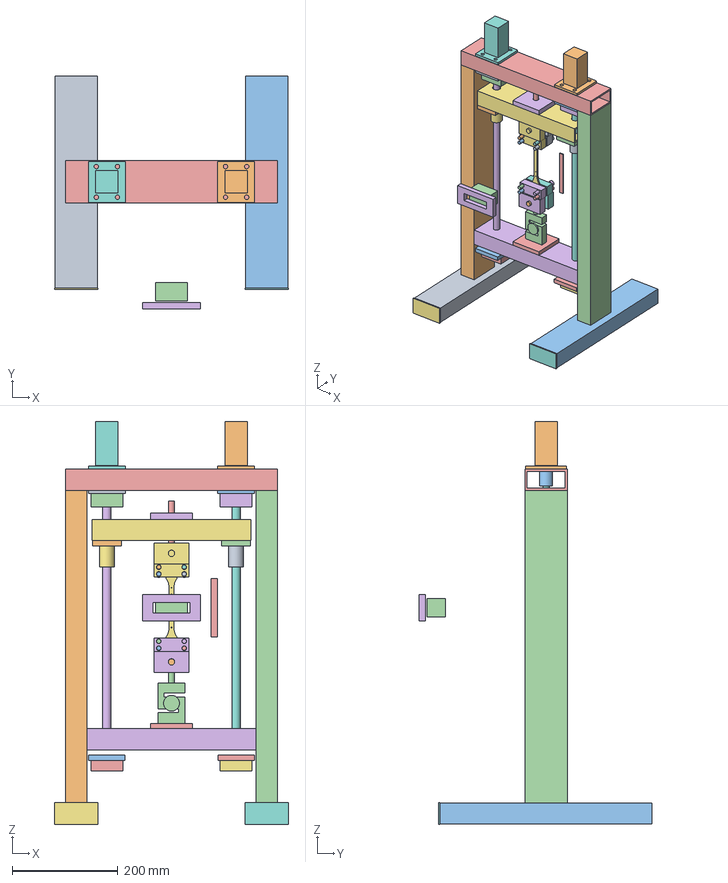
[picture p18: CAD file, 2026-10-24]
profile/study-v0.4/cad/MT02_source_derived_layout.FCStd
442.0 x 440.0 x 761.0 mm
FootLeft
ColumnLeft
FootRight
ColumnRight
TopBeam
BottomBeam
Crosshead
MotorMountLeft
FixedMountLeft
NutMountLeft
FloatingMountLeft
FixedBK12Left
FloatingBF12Left
ScrewLeft
BallNutLeft
MotorLeft
CouplingLeft
MotorMountRight
FixedMountRight
NutMountRight
FloatingMountRight
FixedBK12Right
FloatingBF12Right
ScrewRight
BallNutRight
MotorRight
CouplingRight
LoadCell
LoadCellBaseMount
LowerGripRear
UpperGripRear
LowerGripFront
UpperGripFront
LowerGripPin
LowerClampBolt0
LowerClampBolt1
LowerClampBolt2
LowerClampBolt3
UpperGripPin
UpperClampBolt0
UpperClampBolt1
UpperClampBolt2
UpperClampBolt3
LowerStudEye
UpperStudEye
CentralSpreader
NominalCoupon
Mark75Low
Mark75High
Mark50Low
Mark50High
CameraEnvelope
CalibrationTarget
CameraMount
EndCapLeft
EndCapRight
