mk0000001/Open-Pull-Profile/profile/study-v0.4/print-candidates/Engineering_custom_150x2x2.stl

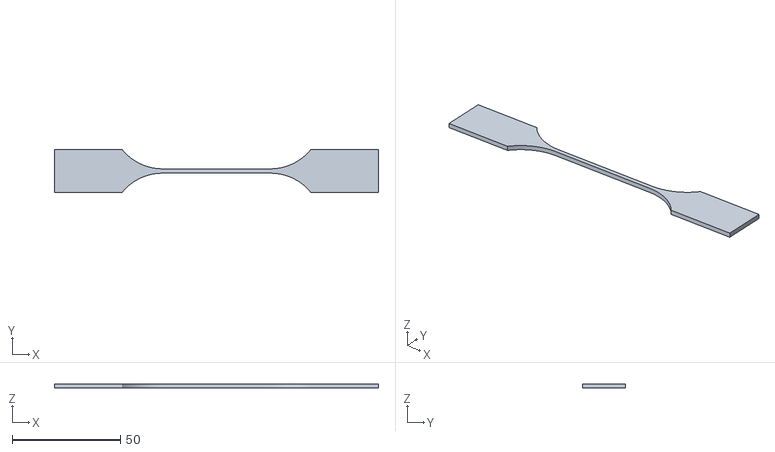
[picture p19: CAD file, 2026-10-24]
profile/study-v0.4/print-candidates/Engineering_custom_150x2x2.stl
150.0 x 20.0 x 2.00
