mk0000001/Open-Pull-Profile/profile/build-v0.3/cad/OpenPull_v0.3.0-costdown-layout.FCStd

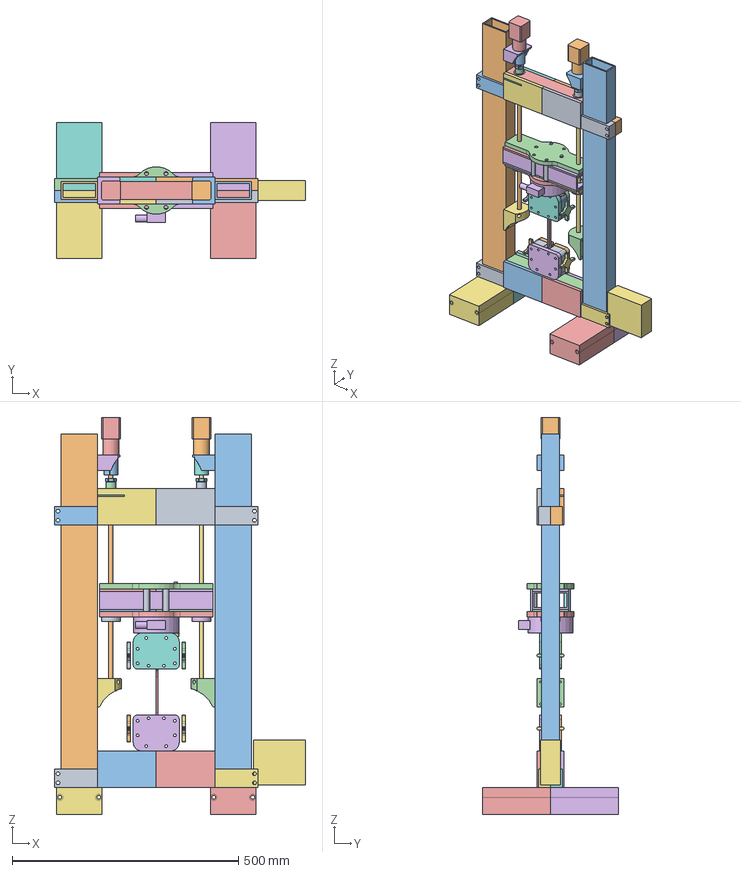
[picture p20: CAD file, 2026-10-24]
profile/build-v0.3/cad/OpenPull_v0.3.0-costdown-layout.FCStd
555.0 x 300.0 x 877.0 mm
Original_Part__Feature
Original_Part__Feature001
Original_Part__Feature002
Original_Part__Feature003
Original_Part__Feature004
Original_Part__Feature005
Original_Part__Feature006
Original_Part__Feature007
Original_Part__Feature008
Original_Part__Feature009
Original_Part__Feature010
Original_Part__Feature011
Original_Part__Feature012
Original_Part__Feature013
Original_Part__Feature014
Original_Part__Feature015
Original_Part__Feature016
Original_Part__Feature017
Original_Part__Feature018
Original_Part__Feature019
Original_Part__Feature020
Original_Part__Feature021
Original_Part__Feature022
Original_Part__Feature023
Original_Part__Feature024
Original_Part__Feature025
Original_Part__Feature026
Original_Part__Feature027
Original_Part__Feature028
Original_Part__Feature029
Original_Part__Feature030
Original_Part__Feature031
Original_Part__Feature032
Original_Part__Feature033
Original_Part__Feature034
Original_Part__Feature035
Original_Part__Feature036
Original_Part__Feature037
Original_Part__Feature038
Original_Part__Feature039
Original_Part__Feature040
Original_Part__Feature041
Original_Part__Feature042
Original_Part__Feature043
Original_Part__Feature045
Original_Part__Feature046
Original_Part__Feature047
Original_Part__Feature048
Original_Part__Feature049
ColumnLeft
ColumnRight
BeamFixedBottom
BeamFixedTop
BeamMoving
FootLeftFront
FootLeftBack
WrapLeftBottomFront
WrapLeftBottomBack
WrapLeftTopFront
WrapLeftTopBack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
