mk0000001/Open-Pull-Profile/profile/study-v0.4/print-candidates/Nominal_A1like_170x20x4.stl

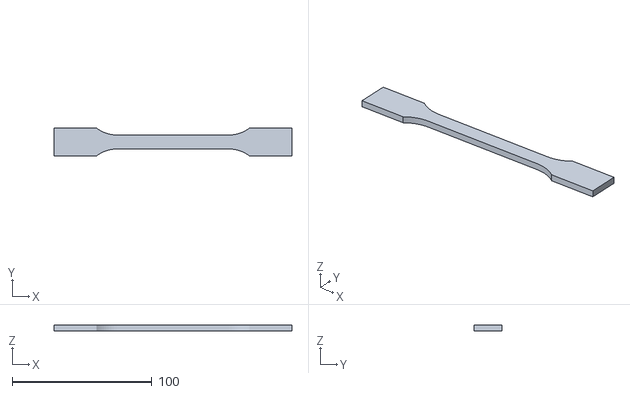
[picture p22: CAD file, 2026-10-24]
profile/study-v0.4/print-candidates/Nominal_A1like_170x20x4.stl
170.0 x 20.0 x 4.00
