mk0000001/Open-Pull-Profile/profile/build-v0.3/printed-candidates/FootLeftBack.stl

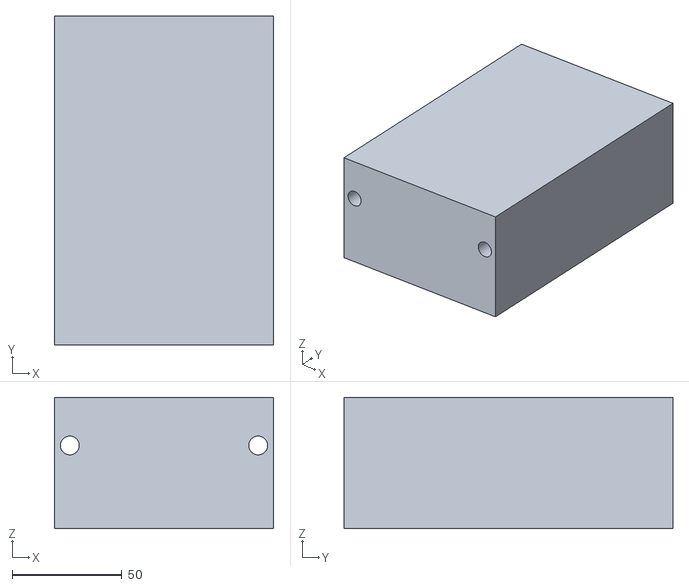
[picture p24: CAD file, 2026-10-24]
profile/build-v0.3/printed-candidates/FootLeftBack.stl
100.0 x 150.0 x 60.0
