mk0000001/Open-Pull-Profile/profile/build-v0.3/printed-candidates/WrapLeftTopFront.stl

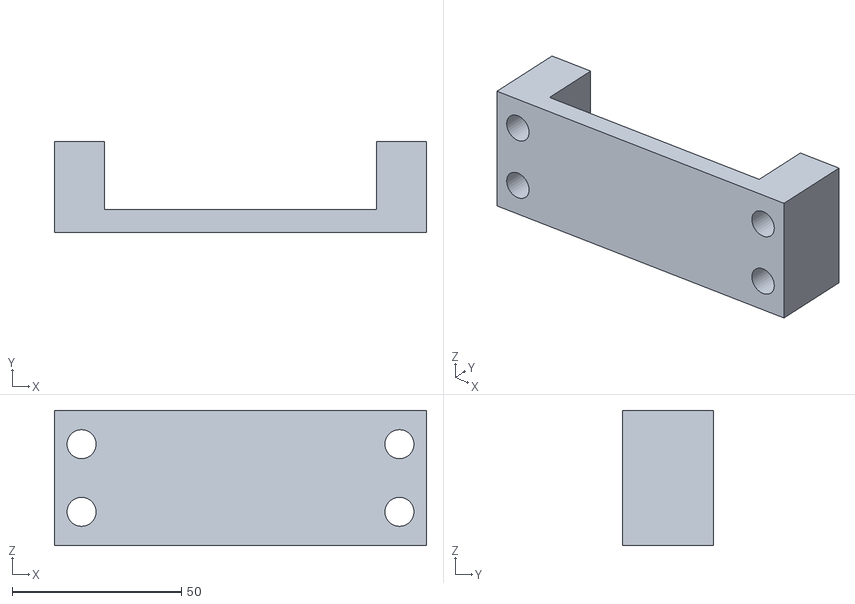
[picture p25: CAD file, 2026-10-24]
profile/build-v0.3/printed-candidates/WrapLeftTopFront.stl
110.0 x 27.0 x 40.0
