mk0000001/Open-Pull-Profile/profile/build-v0.3/printed-candidates/ElectronicsBox.stl

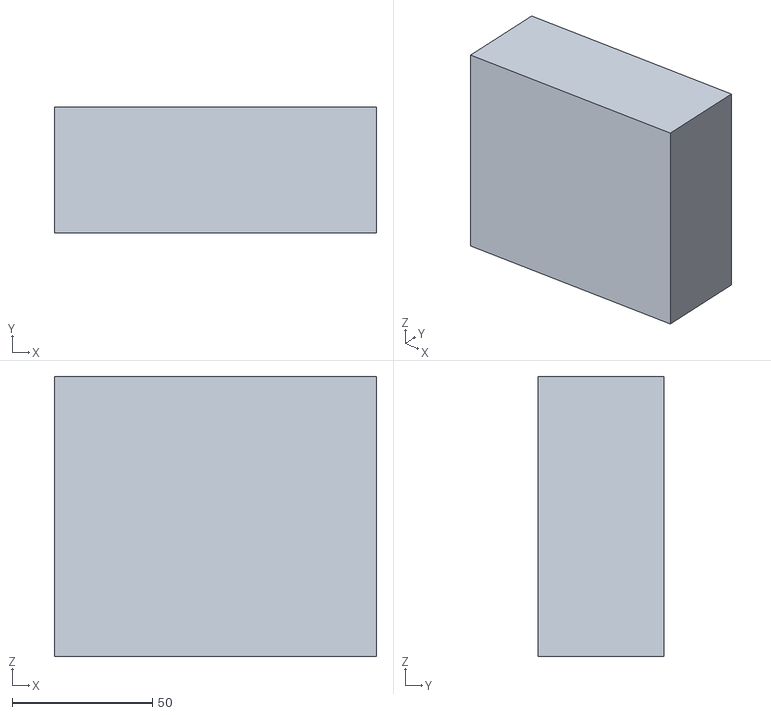
[picture p26: CAD file, 2026-10-24]
profile/build-v0.3/printed-candidates/ElectronicsBox.stl
115.0 x 45.0 x 100.0
