mk0000001/Open-Pull-Profile/(list of files, cad)

Other CAD files:
profile/build-v0.3/printed-candidates/BeamFacingTopLeftFront.stl
profile/build-v0.3/printed-candidates/BeamFacingTopRightBack.stl
profile/build-v0.3/printed-candidates/CrossheadPadLowerLeft.stl
profile/build-v0.3/printed-candidates/WrapLeftTopBack.stl
profile/build-v0.3/printed-candidates/FootRightFront.stl
profile/build-v0.3/printed-candidates/WrapRightTopBack.stl
profile/build-v0.3/printed-candidates/WrapRightBottomBack.stl
profile/build-v0.3/printed-candidates/BeamFacingTopRightFront.stl
profile/build-v0.3/printed-candidates/WrapLeftBottomBack.stl
profile/build-v0.3/printed-candidates/FootRightBack.stl
profile/build-v0.3/printed-candidates/BeamFacingTopLeftBack.stl
profile/build-v0.3/printed-candidates/FootLeftFront.stl
profile/build-v0.3/printed-candidates/CrossheadPadUpperRight.stl
profile/cad/OpenPull_Profile_v0.1.0-design.FCStd
profile/domestic-v0.2/cad/OpenPull_Profile_v0.2.0-interface-review.FCStd
