mk0000001/Open-Pull-Profile/profile/build-v0.3/PRINTED_FRAME.ko.md

# 출력 프레임 비용·이상화 구조 검토

2026-10-24. **현재 CAD 체적에서는 순수 출력안과 M8봉 보강안 모두 프로파일 유지보다 코어 부품 원가가 높다.** 분할 기둥과 빔의 접합부가 정의되지 않아 아래 계산으로 2kN 정격을 부여할 수 없다. 이 문서는 계산·출처 검토만 수행했으며 코드·CAD·Git은 수정하지 않았다.

## 공식 Ender 3 NG 자료의 적용 범위

- [RH3D 공식 프레임 구성](https://rh3d.xyz/E3NG_v1_2/advanced/config): 출력 수직재는 **legacy**, 2040 추가는 강성 개선, 앞쪽 금속 압출재를 더하는 **Ultimate frame**은 권장 구성으로 설명한다.
- [RH3D 공식 출력 지침](https://rh3d.xyz/E3NG_v1_2/advanced/printing_parts): ABS/ASA를 가장 권장하며, PETG는 더 유연하여 프레임 강성을 낮춘다고 명시한다. 해당 프린터의 권장값은 4 perimeter·상하5층·30% infill·0.2mm layer이다. 이 설정은 아래 6mm 벽체의 유효 단면이나 시험기 강도를 보증하지 않는다.
- [설계자 공식 PDF](https://raw.githubusercontent.com/RH3D/E3NG/main/manual/Build_guide_E3NG_v1.2.pdf): **p31**의 `PRINTED VERTICALS` 구성도 Ender 3의 **4040×290mm 금속 압출재 두 개**를 사용한다. **p86**은 상하 압출재 사이 높이를 **310mm**로 정렬한다. 따라서 NG의 출력 수직재 사례는 **길이780mm의 4분할 올플라스틱 기둥과 2kN 시험 하중을 검증한 사례가 아니다.** [설계자 GitHub](https://github.com/RH3D/E3NG)에서 공식 PDF의 소유 관계도 확인했다.

## 입력값과 계산 조건

기둥 두 개에 각각 압축 **P=1,000N**, 길이 **L=780mm**, 양단 핀 이상화 **K=1**. 기둥 단면은 **80X×60Y, 벽6mm**, 각 기둥은 **195mm 모듈 네 개**. 순수 출력안은 주요 다섯 압출재를 모두 출력재로 바꾸고 통상 조립 볼트만 사용한다. 보강안은 출력 기둥에 **각 두 개, 총 네 개의 M8봉**을 X=±27/Y=0 위치에 두고 **금속 4080 빔 세 개**를 유지한다.

PETG **유효 E=800MPa**를 기준으로 **1,000/1,500MPa**를 민감도 계산한다. 이는 선택한 설계 가정이며 실제 출력품의 측정치·허용값이 아니다. [eSUN 공식 PETG TDS, 2025.07 v2.0](https://www.esun3d.com/media/esun/catalog/certification/product/PETG/eSUN_PETG_Filament_TDS_1.pdf)는 밀도 **1.27g/cm³**, 굽힘탄성률 XY **1,228.33MPa**/Z **1,276.45MPa**를 제시한다. 시험편은 **100% infill**, P1S·0.4mm nozzle 등 명시 조건이며 실제 출력 조건에 따라 성능이 달라진다고 설명한다. **굽힘탄성률을 이 분할 구조의 축방향·장기 유효 E로 확정하지 않았다.** 단가에 사용하는 태강 PETG의 보증 물성으로 eSUN 값을 전용하지도 않았다. 밀도1.27은 이번 질량 환산의 가정이다.

각 계산은 등단면·선형탄성·정렬된 하중·접합부 무슬립을 가정한 **연속 부재의 강성 상한 / 변형 하한**이다. 접합면 회전·볼트 유격·층간 방향·구멍·크리프·편심·초기 휨·국부 좌굴은 포함하지 않는다. FEA나 실물 검증 결과가 아니다. 6mm 기하 벽체의 전 단면을 사용했으므로, 낮은 infill로 질량을 줄일 때 동일한 A/I/E를 그대로 유지할 수는 없다.

## 기둥: 연속 부재 기준

`A=80×60−68×48=1,536mm²`.
`Iweak=(80×60³−68×48³)/12=813,312mm⁴`.
`Istrong=(60×80³−48×68³)/12=1,302,272mm⁴`.
`Pcr=π²EIweak/(KL)²`, `δ=PL/(EA)`; 평균 압축응력은 **0.651MPa**이다.

| 가정 E (MPa) | 컬럼 1개 이상 Euler Pcr (N) | Pcr/1,000N* | 축방향 압축 δ (mm) |
|---:|---:|---:|---:|
| 800 | 10,555 | 10.55 | **0.635** |
| 1,000 | 13,194 | 13.19 | **0.508** |
| 1,500 | 19,791 | 19.79 | **0.339** |

두 기둥은 병렬이므로 전체2kN에서 높이 변화는 표의 δ와 같으며 두 배로 더하지 않는다. 전체 축하중 기준 컴플라이언스 `C=δ/2kN`는 E800/1,000/1,500에서 **0.317/0.254/0.169mm/kN**이다. 같은 길이의 금속 기둥은 뒤의 KHP-4080L 단면적981.2mm² 및 E69GPa 참고 가정에서 δ약**0.0115mm**이다.

*하중비 참고값이며 접합·재료·불완전성을 반영한 설계 안전계수가 아니다. 각 기둥에는 직렬 접합 세 군데가 있으므로 **모듈이195mm라는 이유로 전체 좌굴길이를195mm로 줄이면 안 된다.** 접합부가 외부 횡지지 없이 힌지처럼 회전하면 연속 기둥 가정 자체가 성립하지 않는다. CAD의 보스·칼라는 비용 체적에는 포함했으나 이 단순 단면 계산에는 강성 가산하지 않았다.

## 출력 빔과 4080 비교

고정 빔은 **60Y×80Z, 벽6mm**, `I=1,302,272mm⁴`, 지지점 X=±170 → **L=340mm**. 상부에는 X=±100에 **각1,000N**, 지지점에서 하중까지 `a=70mm`; 하부는 중앙 **2,000N**. 이동 빔은 **80Y×40Z, 벽6mm**, `I=302,272mm⁴`, 나사 사이 **L=200mm**, 중앙 **2,000N**. 중간 분할면에서도 연속 단면이 유지된다는 이상화이다. 고정 빔의 실제 길이260mm 몸체와 끝 연결부가 지지 중심까지 이어진다면, 이 표는 그 연결부도 같은 강성이라고 가정한 값이다.

상부 `δmid=P_each·a·(3L²−4a²)/(24EI)`; 중앙 집중하중 빔 `δmid=FL³/(48EI)`; `σnom=Mmax·c/I`.

| 부재 / 하중 | 출력 E800 δ (mm) | E1,000 δ | E1,500 δ | 출력 명목 최대응력 (MPa) | 금속4080 참고 δ (mm) |
|---|---:|---:|---:|---:|---:|
| 고정 상부 / 두 점 각1kN | **0.916** | 0.733 | 0.489 | 2.15 | **0.0211** |
| 고정 하부 / 중앙2kN | **1.572** | 1.258 | 0.838 | 5.22 | **0.0362** |
| 이동 빔 / 중앙2kN | **1.378** | 1.103 | 0.735 | 6.62 | **0.0288** |

금속 비교는 **EAl=69,000MPa 가정**, KHP-4080L의 강축 **655,800mm⁴**(80Z) / 약축 **167,800mm⁴**(40Z)를 사용한 조건부 참고다. [단면 출처·YJ와의 형상 매칭 및 단위 조판 한계](compact-frame.md)를 따른다. E800 대비 굽힘강성은 고정 빔 약43배, 이동 빔 약48배 차이다. 명목응력이 PETG 단기 인장강도보다 작다는 이유로 분할 접합부·층간·장기 하중까지 통과했다고 판정할 수 없다. SCREENING.json은 부재 변형을 단순 합산한 약2.4–4.5mm의 이상화 지표도 제공한다. 이는 실제 전체 장치 변위나 보정계수의 검증값이 아니다.

## M8봉 보강안의 조건

가격 대상은 [77g M8×1m 스텐 전산봉 ly_H39183](https://www.77g.com/products/ly_H39183) **3,700원×4개=14,800원**, 각820mm 절단. 금속 강도등급·피치·가격 VAT 포함 여부·최종 배송은 공개 미확정이다. 계산은 **철강 E=200,000MPa 가정**, 나사 골지름 **droot=6.47mm 가정**을 써서 `Ar=32.877mm²`, `Ir=86.018mm⁴`로 두었다. 매끈한 Ø8 단면으로 M8 전나사봉을 계산하지 않았다.

양 끝 **금속 엔드플레이트(90×70×5mm 총4장)**가 플라스틱과 봉에 동시에 하중을 넣고, 풀림·미끄럼이 없으며 봉이 필요한 횡지지를 받는 이상적 병렬 모델은 `EA_total=EpAp+2EsAr`(기둥당 두 봉)이다.

| PETG 가정 E (MPa) | 보강 기둥 축압축 δ (mm) | 봉 1개가 받는 축력 (N) | 완전 합성 약축 이상 Euler Pcr (N/기둥) |
|---:|---:|---:|---:|
| 800 | **0.0542** | **457** | 11,113 |
| 1,000 | **0.0531** | **448** | 13,752 |
| 1,500 | **0.0505** | **425** | 20,349 |

그러나 **지지 없는 M8봉 자체의 L780/K1 Euler 값은279N/개**로 위 예상 축력보다 작다. 전체780mm가 무지지라면 위 병렬 모델의 높은 축강성을 그대로 쓸 수 없다. 실제 무지지길이가820mm이면 약253N/개다. 정말195mm마다 횡이동이 억제되면 이상값은 **4,465N/개**로 커지지만, 움직일 수 있는 출력 칼라를 끼웠다는 사실만으로 그 횡지지를 확정할 수 없다. 두 봉이 Y=0에 있어 약축 휨에는 레버암 이득도 작다. 참고로 매끈한 Ø8봉의 L780 이상 Euler 값은652N/개이나, 그 값은 M8봉의 값이 아니다. 이 매우 세장한 봉의 검토는 **탄성 Euler 좌굴**이며 소성 강도 검증이 아니다. 엔드플레이트 굽힘·와셔 지압·볼트 잠금·접합 횡지지 상세는 남은 설계 항목이다.

## 체적·실매입 비용

질량은 `CAD mm³÷1,000,000×1.27kg/L`; 소비 원가는 **15,000원/kg**. [태강 PETG black 1.75mm/1kg, product737/P0000BCJ000B](https://3dprinterstore.co.kr/product/detail.html?product_no=737&item_code=P0000BCJ000B)의 확인 단가이며 VAT 포함, 기본 배송4,000원이다. 실패 출력·퍼지·서포트·전력·시간은 가산하지 않았다.

| 범위 | 체적 / 환산 질량 | 필라멘트 소비 원가 | 새 1kg 롤 필요량 / 매입금액 |
|---|---:|---:|---:|
| **기둥 벽체만** 80×60t6×780×2 | 2.39616L / **3.04312kg** | **45,647원** | 4롤 / **60,000원** |
| **순수 출력 CAD 전체 newPrintedFrame** | **4,473,661.3mm³ / 5.68155kg** | **85,223원** | 6롤 / **90,000원** |
| **보강 CAD newPrintedFrame**(기둥+칼라) | **3,380,461.2mm³ / 4.29319kg** | **64,398원** | 5롤 / **75,000원** |

CAD 체적은 상위 작업에서 반환한 실제 그룹 합계 값이며 이 연구에서 CAD를 다시 열어 측정한 값은 아니다. 순수안은 기둥8모듈·연속 보스·폭88mm의 분할 칼라6세트·분할 빔3개를, 보강안은 기둥·칼라를 포함한다. 공통 발·마운트 등 추가 출력은 별도다. 코어 비교 기준인 [YJ 금속 780mm 기둥 두 개](https://www.yjprofile.co.kr/goods/goods_view.php?goodsNo=1000000051)는 **51,040원**, 빔260mm 세 개는 **28,710원**, 다섯 프로파일 합계 **79,750원(VAT 포함)**이다.

| 코어 구성 비교 — 배송·공통 부품 제외 | 소비량 원가 기준 | 새 롤 구매 기준 | 금속 코어79,750 대비 차이(소비량 기준) |
|---|---:|---:|---:|
| 금속 프로파일 다섯 개 | **79,750** | **79,750** | 기준 |
| 순수 출력: 필라멘트+접합 하드웨어 여유15,000 | **100,223** | **105,000** | **+20,473** |
| 보강: 필라멘트+M8봉14,800+금속 빔28,710+판 여유20,000 | **127,908** | **138,510** | **+48,158** |

**15,000원 접합 하드웨어와 20,000원 엔드플레이트는 견적이 아닌 예산 여유금**이다. 금속안에도 체결부 비용이 필요하므로 이 표를 완성 BOM 총액으로 부르지 않는다. 그래도 순수 출력의 필라멘트만85,223원으로 프로파일 다섯 개79,750원을 이미 넘고, 보강안도 판 여유금을 제외해도107,908원이다. 기존 필라멘트를 무료로 취급하지 않은 동일 원가 비교다. 금속 프로파일 주문의 확인 기본 배송은3,000원; 봉 배송·세금과 판 가공 견적은 미확정이므로 합계에 섞지 않았다.

**판단:** 기둥 벽체만 비교할 때도 소비 원가 절감은 **5,393원**뿐이고 새 네 롤 구매는 금속 기둥보다8,960원 비싸다. 실제 분할 체적까지 반영하면 출력안의 비용 이점은 사라진다. 출력 조립·모듈 교환성 실험안으로는 유지할 수 있으나, **50만원 예산 절감이나 2kN 검증 완료를 뒷받침하는 안으로 채택할 근거는 확보하지 못했다.**
