mk0000001/Open-Pull-Profile/profile/build-v0.3/compact-frame.md

# 원본 폭 유지 저가 금속 프레임 — YJ 4080 절단품

**2026-10-24 KST 공개 판매가 확인.** [YJ/영진프로파일 4080 실버, 상품1000000051](https://www.yjprofile.co.kr/goods/goods_view.php?goodsNo=1000000051), 브랜드 경희프로파일·제조사 경희알미늄·대한민국 원산지. 옵션 제목에 **`4080프로파일(실버) [부가세포함]`** 명시. CAD·Git·구매·판매처 문의는 하지 않았다.

| 정확 절단 길이 | 길이구간 옵션 / 옵션번호 | HTML 기본가+옵션가 | VAT 포함 개당 | 수량 | 소계 |
|---|---|---:|---:|---:|---:|
| 기둥 **780mm** | `701~800(mm)` / **2316** | 80+25,440 | **25,520** | 2 | **51,040** |
| 대체 기둥 **840mm** | `801~900(mm)` / **2317** | 80+28,630 | **28,710** | 2 | **57,420** |
| 주하중 빔 **260mm** — 상부고정·하부고정·이동 크로스헤드 | `201~300(mm)` / **2311** | 80+9,490 | **9,570** | 3 | **28,710** |

- **780mm 기둥안:** 상품79,750 + 표시 배송3,000 = **82,750원**.
- **840mm 기둥안:** 상품86,130 + 표시 배송3,000 = **89,130원**. 780안보다 **6,380원** 추가.
- 같은 기둥에서 **금속 빔 세 개를 유지하는 추가 재료비는 28,710원**이다. 기둥 두 개만 주문하는 경우와 모두 다섯 개 주문하는 경우는 공개 배송구간이 같아 배송 증가를 잡지 않았다. 출력 빔의 실제 필라멘트 무게를 모르는 상태이므로 절감액을 28,710원 전부라고 보지는 않는다.

**선택 방법·배송 근거:** 해당 길이구간을 선택하고 필수 `세부길이(mm)/수량`에 **780mm×2 또는 840mm×2, 260mm×3**를 적는 구성. 구간 최고 길이로 가격이 묶이므로 260mm를 미터단가로 비례 계산하지 않았다. 원문 배송표는 `배송비3,000원 / 0개 이상~1개 미만0원 / 1개 이상7개마다추가3,000원`; 다섯 절단품은 기본구간이다. 도서산간 추가와 결제 단계의 최종 운임은 별도이며, 탭·홀·브래킷·체결물은 위 가격에 없다. 공개 옵션 재고는 2316=99,999 / 2317=99,988 / 2311=99,999로 표시되지만 납기 확약은 아니다.

**실단면 근거:** [YJ 4080 실제 단면도](https://cdn-saas-web-219-166.cdn-nhncommerce.com/yjprofile1_godomall_com/data/editor/goods/200308/2_032944.png)를 시각 확인했다. 외형 **80×40mm**, 슬롯 입구 **8.3mm**, 코너홀 **4-Ø6**, 코어 **2-Ø6.8**, 코너홀 가로피치70mm/세로피치30mm, 재질 **A6N01S-T5**, 아노다이징이다. [YJ 표지](https://cdn-saas-web-219-166.cdn-nhncommerce.com/yjprofile1_godomall_com/data/editor/goods/200308/1_032944.png)는 **2.65kg/m**. 기둥을 X폭80×Y깊이40으로 두고 중심±170mm에 배치하면 **외폭420/내측간격260mm**가 맞는다. 빔의 단면 방향은 별도로 정해야 한다.

**관성모멘트는 출처와 추론을 구분:** [제이피티 경희 KHP-4080L 상품2028](https://m.jptmro.com/product/detail.html?product_no=2028)의 [공개 카탈로그 이미지](https://m.jptmro.com/web/%EA%B2%BD%ED%9D%AC%EC%95%8C%EB%AF%B8%EB%8A%84/profile/KHP4080L.jpg)는 **동일한 2.65kg/m·80×40·슬롯8.3·4-Ø6·2-Ø6.8·70/30mm 피치와 단면 형상**을 보이며 단면적 **981.2mm²**, I 숫자 **16.78 / 65.58**을 싣는다. 그림 단위는 `x10cm4`로 조판이 불명확하다. 통상 해석인 **16.78/65.58cm⁴ = 167,800/655,800mm⁴**는 *KHP-4080L 참고치*로만 쓴다. YJ 상품명이 4080L 또는 이 I값을 직접 보증하지 않으므로 **YJ 고유의 확정 I값 확보로 보고하지 않는다**. 일반 KHP-4080 중량형은 3.08kg/m·4-Ø8·세로피치27로 다르며 그 I값을 혼용하면 안 된다.

**판단:** 주하중 빔을 금속으로 유지하는 선택은 이 세 개의 실제 원가 **2.87만원**으로 뒷받침할 수 있다. 다만 가격·단면 매칭은 출력 클램프/너트 캐리어/볼트 연결부를 포함한 전체 하중 경로의 강도 검증을 대신하지 않는다. 공식 YJ I값 없이 임의의 처짐·허용하중을 확정하지 않았다.
