mk0000001/Open-Pull-Profile/profile/build-v0.3/sources/original-drive-quote.md

# 원본형 14:1 구동부 견적 조사

확인일: 2026-10-24 KST. 범위: NEMA17 유성감속모터 2개 + TR10 리드2·500mm 2조 + 8/10 커플링. 구매·문의·CAD·Git 작업 없음. 500N 가공/전자석 조사는 중단했다.

**이 문서는 원본형 구동부 일부의 가격표이며, 완성 시험기 BOM이나 2kN 최소 성능 보증 견적이 아니다. 앞선 산업용 AiS/PGH 구성의 약 216만원은 원본 CNC Kitchen BOM 가격으로 설명하면 안 된다. 예산 단위는 한국 원화 50만원이다.**

## 원본에 가까운 구매 후보와 공개가격

| 항목 / 수량 | 정확한 선택 | 공개 단가 / 2개 소계 | 세금·운송·확인 수준 |
|---|---|---:|---|
| STEPPERONLINE 모터 ×2 | `17HS19-1684S-PG14` | **₩44,444.40 / ₩88,888.80** | 제조사 한국어 사이트 표시가격. 중국발 국제직판이며 국내 재고가 아니다. 한국 VAT 포함 여부, 한국행 국제운송료, 실제 수입비용 미확정. EN 표시가격은 $28.86/개, 2개 $57.72. |
| TR10 나사 + 황동너트 ×2 | Nasspop 상품616, `외경10 리드2 500mm(M4-5)`, **`P00000XS000K`** | **₩9,800 / ₩19,600** | 국내 판매, 중국산/자체제작 표기. 피치2·리드2 선택이며 리드4 옵션과 구분. VAT 포함 가격으로 해석되는 Cafe24 세액 분리값 확인. 물리 재고 실사 아님. |
| 저가 리지드 커플링 ×2 | Nasspop 상품854, `D20 X L20` → `8x10`, **`P0000BGW000K`** | **₩2,400 / ₩4,800** | 국내 판매/VAT 포함. D20·L20mm. 허용토크·미끄럼토크·나사 체결토크·최소 삽입길이 자료 없음. 원본형 저가 견적용이며 2kN용 확정품 아님. |

모터 공식 [EN 제품/문서](https://www.omc-stepperonline.com/nema-17-stepper-motor-bipolar-l-48mm-w-gear-ratio-14-1-planetary-gearbox-17hs19-1684s-pg14), [한국어 원화 가격](https://www.stepperonline.co.kr/nema-17-%EC%8A%A4%ED%85%8C%ED%8D%BC-%EB%AA%A8%ED%84%B0-%EB%B0%94%EC%9D%B4%ED%8F%B4%EB%9D%BC-l-48mm-w-%EA%B8%B0%EC%96%B4%EB%B9%84-14-1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), 국내 [TR10 상품616](https://nasspop.com/product/detail.html?product_no=616), [커플링 상품854](https://nasspop.com/product/detail.html?product_no=854).

Nasspop 옵션 JSON의 `option_price`가 최종 선택가격이다. 상품616의 350mm 시작가격 ₩7,600에 500mm 옵션 ₩2,200을 더한 ₩9,800이다. `is_selling=T`, `use_soldout=F`이나 재고관리 비활성화여서 수량을 실제 창고 재고로 인용하지 않는다. 기본 공급가/세액은 6,909+691=7,600원; 커플링 기본은 2,000+200=2,200원이다.

## 배송·예산을 분리한 소계

| 구분 | 금액 |
|---|---:|
| 위 6개 부품의 공개 표시가격 합계 | **₩113,288.80** |
| Nasspop 국내 배송 | **₩6,500~7,000 예상** |
| 국내 배송까지의 부분합 | **₩119,788.80~120,288.80** |
| 모터 국제 배송 | **미확정: 한국 주소/수량2의 운임 견적 필요** |
| 모터 관세·수입VAT·통관/결제수수료 | **미확정: 0원으로 확정하지 않음** |

Nasspop은 기본 배송비 ₩3,500 외에 **350mm 이상 장척물을 따로 발송**한다고 본문에 명시한다. 추가 배송비 옵션 ₩3,000을 선결제하거나 보통 ₩3,500 착불이다. 500mm 2개가 한 장척 묶음으로 합배송되는 가정의 합계이며, 결제단계 확인 전 고정 배송가로 표현하지 않는다.

빠른 예산 검토에서 국제 배송 ₩40,000 + 수입/결제 비용 ₩20,000을 **검증 전 충당금**으로 잡으면 이 부분은 약 **₩180,300**이다. 이는 배송 견적·세금 산정 결과가 아니다. 50만원 총예산에서는 이 가정 후 약 32만원이 남지만, 아직 **센서/전자회로/드라이버/전원/프레임/가이드/그립/금속 하중지지/베어링/축단 가공/출력비/시험비**를 모두 넣지 않았으므로 50만원 달성 주장에 사용할 수 없다. 센서는 원본 유지가 전제다.

## 원본 모터의 제조사 자료와 기계 한계

공식 [전체 데이터시트/치수도](https://files.omc-stepperonline.com/17HS19-1684S-PG14_Full_Datasheet.pdf), [토크 곡선](https://files.omc-stepperonline.com/17HS19-1684S-PG14_Torque_Curve.pdf). 공식 제품 페이지가 직접 연결한 파일이다. STEP는 제품 페이지에서 로그인 다운로드로 제공된다. PDF의 웹 추출은 도형/문자 인식이 제한되어 곡선의 개별 점을 수치로 재작성하지 않았다.

| 제조사 공식 제품페이지 항목 | 값 |
|---|---|
| 감속비 / 입력모터 | 상품명14:1, 사양 **13.73:1** / bipolar1.68A, 기어 제외 홀딩토크0.52N·m |
| 기어박스 | 효율80%, 무부하 백래시≤3°, **max permissible3N·m / momentary5N·m** |
| 크기 | 42×42mm, 모터48 + 감속기35 = 본체83mm |
| 출력축 | **φ8×20mm, D-cut15mm** |
| 출력축 하중 한도 | **축방향50N / 반경방향100N** |

**0.52×13.73×0.8≈5.71N·m를 연속 사용 가능한 출력으로 쓰면 안 된다. 기어박스의 3N·m 한도가 먼저 적용된다.** 순간5N·m 역시 시험기 연속 정격으로 사용할 수 없다. 홀딩토크가 실제 드라이버/속도/온도에서의 운전토크를 보증하지 않는다.

계산상 총2kN 균등분배는 축당1kN이다. 리드2mm, 효율을 임의의 설계 가정0.25로 두면 `T=1000×0.002/(2π×0.25)=1.273N·m/축`이다. 기어 한도3N·m와의 비2.36은 이 가정의 토크 비교일 뿐, 장치 안전율/2kN 보증이 아니다. 1–25mm/min이면 출력0.5–12.5rpm, 입력 약6.87–171.6rpm이다. 실제 저속 곡선과 공급 전류/전압으로 시운전해야 한다.

**1kN 축하중을 50N 허용인 감속모터 출력축에 직접 전달할 수 없다.** 별도 금속 스러스트 하중경로·고정 베어링·축 어깨/너트가 필요하며, 커플링은 토크를 전달하도록 배치해야 한다. 무가공 TR10 나사산을 φ10 정밀 베어링 저널로 간주할 수 없고, 나사산 외경φ10에서 φ10 원통 저널을 선삭해 만들 수 없다. 축단/슬리브/허브 연결은 실제 치수 설계 후 별도 견적이다.

TR10 판매자는 원 제조사 이름·공차도·재료 성적·너트 허용하중·수명/윤활 조건을 공개하지 않는다. 판매페이지의 사진/설명은 리드2 옵션 확인 자료이며, 축당1kN 정격 증거가 아니다. 마찰 자립/전원차단 유지도 자동으로 가정하지 않는다.

## AliExpress 확인 결과

`STEPPERONLINE Store`의 후보 경로 [store1984315](https://stepperonline.aliexpress.com/store/1984315)는 검색되지만 직접 접근이 실패했고, 이번 조사에서는 제조사가 공식점으로 연결한 근거와 **정확한 PG14 옵션·수량2·한국배송 최종가격**을 확인하지 못했다. 따라서 **공식 Ali 판매품/가격은 미확정, 견적 대기**다. 일반 판매자의 동일 모델명이나 가격비교사이트 기록을 정품/현행가격으로 대입하지 않았다.

제조사의 [공식 판매채널 공지](https://www.stepperonline.co.uk/important-statement.html)는 `omc-stepperonline.com`과 `stepperonline.co.kr`을 공식 도메인으로 명시한다. 현재 가격 기준은 검증 가능한 공식 국제직판이며, Ali가 더 싸다는 결론도 아직 없다.

## 선택적인 국내 비교와 남은 확인

원본 그대로의 국내 재고 정품 모터는 이번 조사에서 확정하지 못했다. 국내 MotorBank [PGM36-NK174816](https://www.motorbank.kr/goods/goods_view.php?goodsNo=1000016934)는 `1/14` 옵션sno74422가 **₩95,400/개, 2개₩190,800, 15만원 이상 무료배송**이다. VAT 포함/별도 표현은 미확인이다. 원본의 동일 정품으로 취급하지 않는다. 판매자 도면은 φ8×17, D-cut15를 보이지만 상단 표에 다른 모델/φ7이 섞이고 감속비별 길이도 불일치해 제작 기준으로 확정하지 않는다. 추가 산업옵션 조사는 중단했다.

커플링의 정격 자료가 필요한 경우 기존 조사품 [SUNG-IL `SJC-25C-RD-8X10`](https://kr.misumi-ec.com/vona2/detail/221005341064/?HissuCode=SJC-25C-RD-8X10)은 국내 MISUMI **₩31,988 VAT포함/개, 2개₩63,976, 무료배송**이다. 이 선택이면 위 부분합에 **₩59,176 추가**된다. 제조사 권장 삽입10mm/측, D25·L31.3mm, M3체결1.7N·m, rated12N·m. 실제 D-flat 위치는 [제조사 설치지침](https://www.sungilfa.co.kr/en/products/coupling/installation-guide)에 맞추고 삽입/회전 기준선을 마킹한다. 어느 커플링이든 부하 전 실제 축에서 미끄럼 확인과 시운전 후 마킹 검사가 필요하다.

2kN 최소성능의 확정에는 실제 조립품으로 하중계 교정, 양축 동기/편하중, 운전토크와 온도, 체결/미끄럼, 축지지/프레임/그립, 파단 및 전원차단 시 거동 검증이 남는다. 현재 결과는 **원본형 저가 부품을 출발점으로 한 견적 조사**다.
