mk0000001/Open-Pull-Profile/profile/build-v0.3/renders/front.png

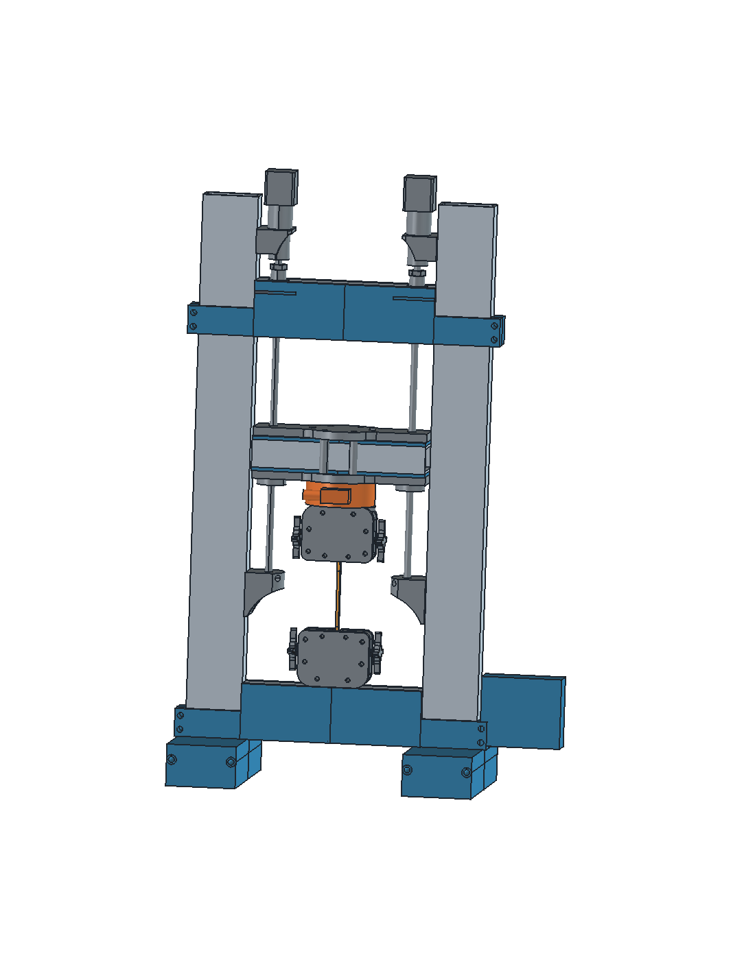
profile/build-v0.3/renders/front.png
