mk0000001/Open-Pull-Profile/CHANGELOG.md

# Changelog

## 0.4.0-engineering-feasibility — 2026-10-25

- Compare UTM V2 and MT02 source BOM, actual demonstrated load, drawing conflicts and domestic/direct manufacturer prices.
- Apply revised600k recommended / strict800k budget excluding printing costs:589084/789084KRW planning totals with freight, tax, fabrication allocations and contingency.
- Save UTM-derived PETG/custom engineering coupon packaging, MT02 reconstructed layout and independent10kN steel-frame/metal-grip/measurement study. Preserve hardware attribution/license boundaries.
- Audit current ISO editions, moisture/orientation and tensile TDS requirements; keep formal2kN/ISO/assembly claims unestablished.
- Preserve all original and frozen v0.1-v0.3 artifacts.

## 0.3.0-costdown-layout — 2026-10-24

- Return to original two geared NEMA17/TR10x2 drives and actual upstream component solids; remove dependence on the prior single-motor belt concept.
- Save separate FreeCAD layouts for cheap4080, segmented printed frame, and printed columns with M8 reinforcement. Add81/86/91-solid reopen/STEP volume checks and bed-sized printed candidates.
- Correct original-BOM price attribution. Separate public prices, shipping/machining allowances, original AEP sensor reference cost and unquoted Zemic alternative. KRW500,000 and a physical2kN guarantee are not established.
- Add analytical stiffness/buckling screening and actual CAD volume costs for NG-inspired printed frame alternatives. No NG geometry copied; frame/bearing/sensor joints and electrical validation remain open.
- Preserve original sources and frozen v0.1/v0.2 artifacts. Publish as a costed layout study, not fabrication drawings.

## 0.2.0-interface-review — 2026-10-24

- Switch sourcing baseline to domestic Korea sales; compare MISUMI economy components with actual Coupang domestic-seller listings. Separate configured live prices, indexed prices and unquoted parts.
- Add drawing-derived Leadshine57CM23-3A motor, C-TBSE1505-861 machined shafts, C-TFK12/C-TFF12 mounting patterns, E-HLGH15-700-B2 guide mates and S5M drive envelopes in a separate CAD package.
- Correct total screw length, guide installed height and original grip cavity17x22; remove unsupported M8 grip stems. Sensor/grip load path intentionally remains incomplete.
- Review corrections: trim crosshead plate front edges after guide height change; shorten FF support bolts to avoid lower-beam penetration; seat motor bridge webs on roof.
- Add 11-position movement checks, interface assertions and explicit procurement/manufacturing HOLD conditions. Preserve v0.1 native/STEP/renders and immutable v0.1.0-design tag.

## 0.1.0-design — 2026-10-24

- Preserve CNC Kitchen Open-Pull history and GPL-3.0 sources.
- Add 4080 profile-frame concept for printed tensile specimens, with original grip geometry and two synchronized SFU1605 screws.
- Add FreeCAD source, native model, STEP, renders, sourcing candidates and verification evidence.
- Design-review version only; no physical load rating, finalized machining drawings, new motor firmware or purchase approval.
- Assembly audit: HOLD procurement; verified domestic 4080 option pricing and CAS SBA-500L selection, found motor shaft/length and guide mounting-height mismatches against manufacturer data.
