mk0000001/Open-Pull-Profile/(commit log)

2026-10-24 feat(cad): add profile frame concept and verified pull clearance
    [CUT_LIST.csv, OpenPull_Profile_v0.1.0-design.FCStd, OpenPull_Profile_v0.1.0-design.step]
2026-10-24 docs: add sourcing options and reproducible design release checks
    [BOM.csv, OpenPull_Profile_v0.1.0-design.FCStd, OpenPull_Profile_v0.1.0-design.step, PLATE_LIST.csv]
2026-10-24 fix(cad): clear joint plate interference and audit assembly blockers
    [BOM.csv, OpenPull_Profile_v0.1.0-design.FCStd, OpenPull_Profile_v0.1.0-design.step, PLATE_LIST.csv]
2026-10-24 design: add v0.2 domestic sourcing and drawing-derived interfaces with explicit assembly holds
    [OpenPull_Profile_v0.2.0-interface-review.FCStd, OpenPull_Profile_v0.2.0-interface-review.step]
2026-10-24 design: add costed original-drive and printed-frame v0.3 studies
    [BeamFacingBottomLeftBack.stl, BeamFacingBottomLeftFront.stl, BeamFacingBottomRightBack.stl, BeamFacingBottomRightFront.stl, BeamFacingTopLeftBack.stl, BeamFacingTopLeftFront.stl, BeamFacingTopRightBack.stl, BeamFacingTopRightFront.stl]
2026-10-24 fix: clear printed-frame splices through the pull travel
    [ColumnLeftModule1.stl, OpenPull_v0.3.0-printed-frame.FCStd, OpenPull_v0.3.0-rod-reinforced.FCStd, SpliceLeft1Front.stl]
2026-10-24 feat: add UTM and MT02 feasibility studies with 600k and 800k budget plans
    [Custom_halfscale_85x10x2.stl, Engineering_10kN_room_temperature_study.FCStd, Engineering_custom_150x2x2.stl, MT02_source_derived_layout.FCStd, Nominal_A1like_170x20x4.stl, PETG_custom_150x5x2.stl, UTM_V2_budget_fixture_study.FCStd]
